nbertamoni/BASIC/README.md

# BASIC stands for Bioimpedance ASIC for Skin Cancer detection
This is a application specific integrated circuit project for skin cancer detection.
UNIC CASS
