nbertamoni/BASIC/documentation/UNIC-CASS_3rd_ed_FUP_2025_12_08.pdf

UNIC-CASS 3rd ed.

# The BASIC Project

# Florianópolis, December 8, 2025

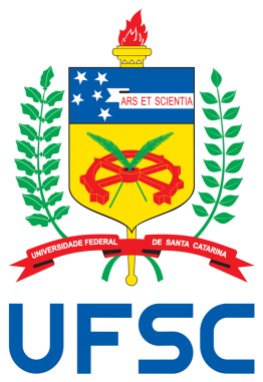
[picture p1: figure]
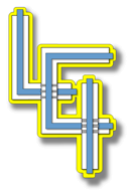
[picture p2: figure]

# A problem

Global cancer growth projections | One more way to help…

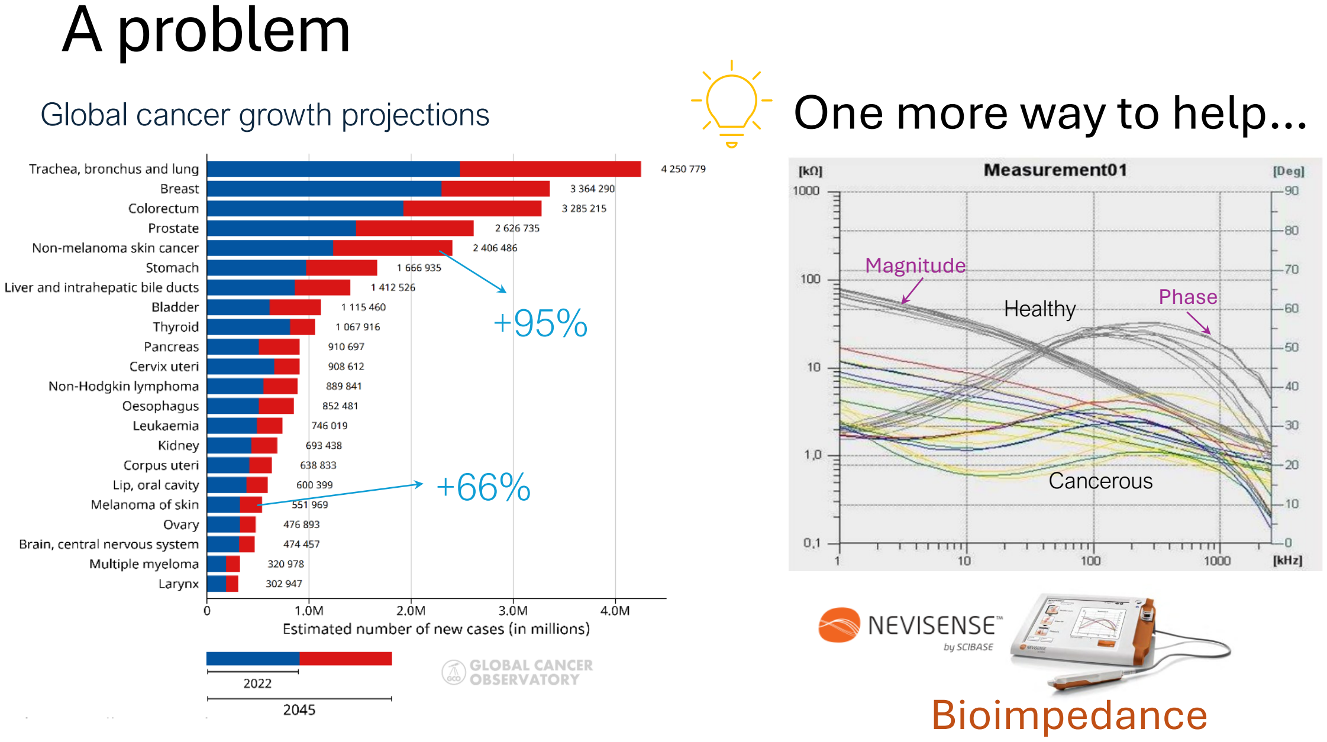
[picture p3: page 2]

+95%

+66%

Healthy

Cancerous

Magnitude
Phase

# Bioimpedance

# The BASIC Project

Bioimpedance | ASIC | UNIC-CASS - 2023 (1st ed.)

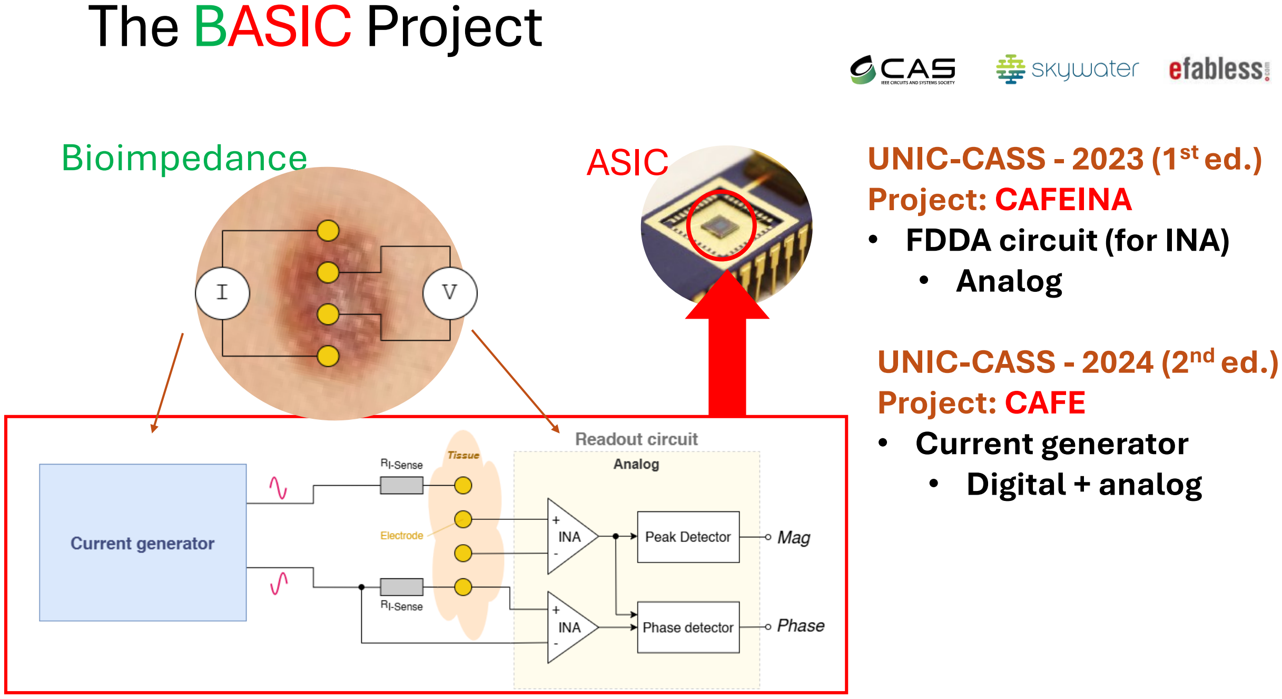
[picture p4: page 3]

# Project: CAFEINA - FDDA circuit (for INA) - Analog

# UNIC-CASS - 2024 (2nd ed.) Project: CAFE - Current generator - Digital + analog

# BASIC – detailed current gen

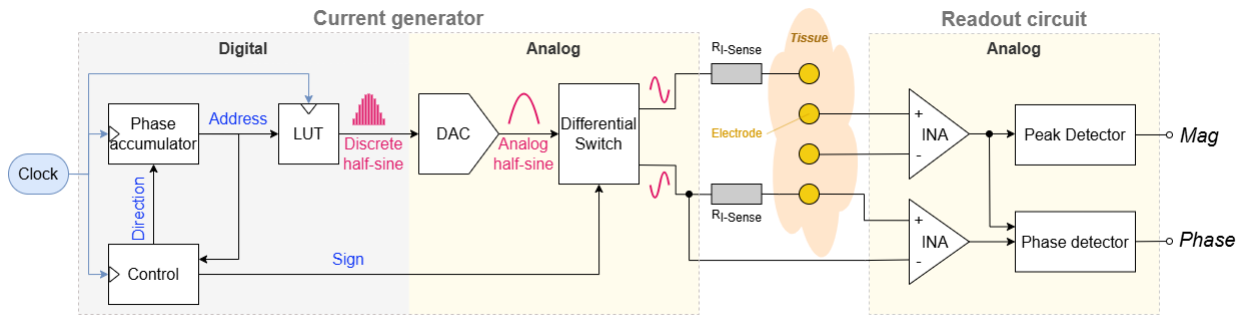
[picture p5: figure]

# BASIC - detailed readout

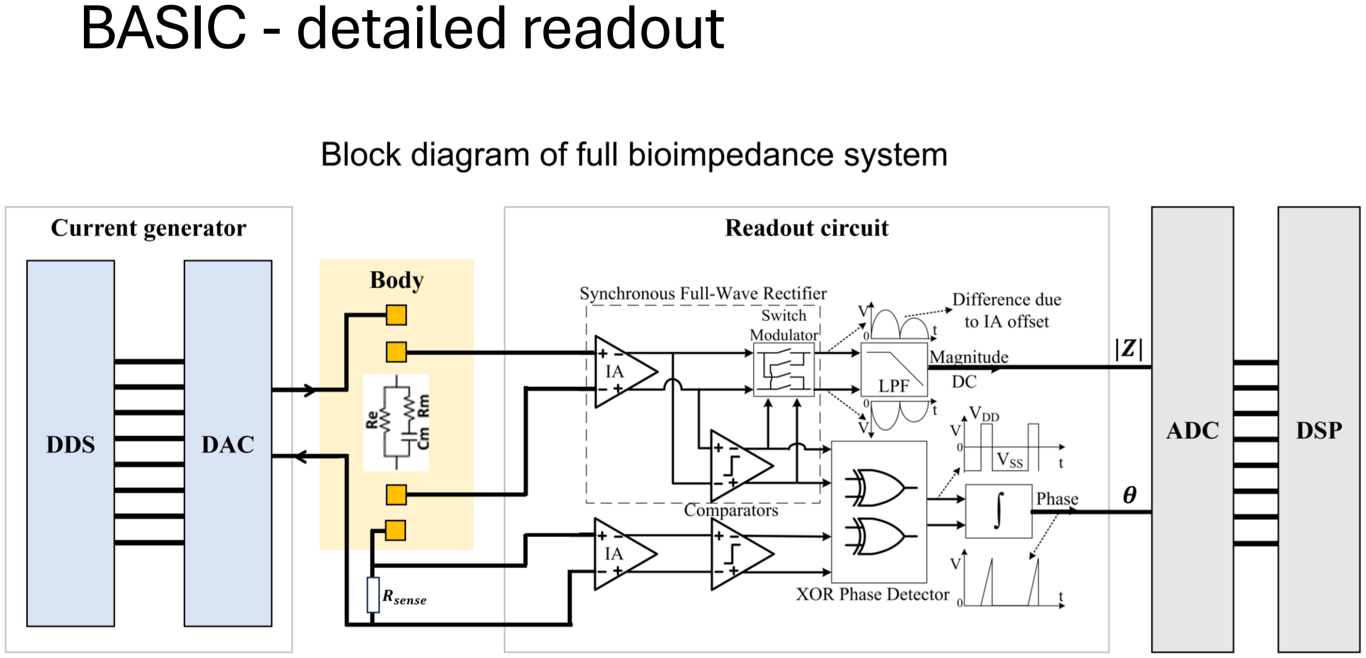
[picture p6: page 5]

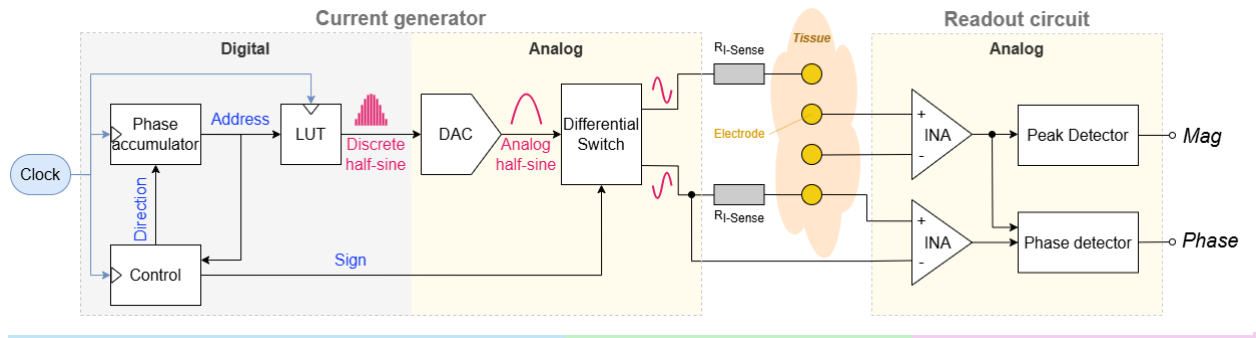
[picture p7: figure]

→ Plan A | → Plan B | → Plan C

# UNIC-CASS 3rd ed. (2025)

## Current generator - Digital: FSM+LUT - Analog: DAC + Diff switch Readout circuit - Analog: INA + Peak detector + Phase detector

## Current generator - Digital: FSM+LUT - Analog: DAC + Diff switch Readout circuit - Analog: INA

## Current generator - Digital: FSM+LUT - Analog: DAC + Diff switch

# Plan A

# | Pin name | Size | Direction | Domain | Description

1 | AVDD | 1 | IO | Power | Supply for analog domain
2 | VSS | 1 | IO | Ground | Ground
3 | DVDD | 1 | IO | Power | Supply for digital domain
4 | CC_P | 1 | IO | Analog | Positive CC
5 | CC_N | 1 | IO | Analog | Negative CC
6 | PU_P | 1 | IO | Analog | Positive PU
7 | PU_N | 1 | IO | Analog | Negative PU
8 | IREF_DAC | 1 | Input | Analog | DAC reference current
9 | IREF_INA | 1 | Input | Analog | INA reference current
10 | IGEN_SEL | 1 | Input | Digital | Current selector
11 | GSEL<1:0> | 2 | Input | Digital | INA gain selector
12 | CLK | 1 | Input | Digital | 1MHz – 510 MHz
13 | RST | 1 | Input | Digital | Rst for digital
14 | VCM | 1 | Input | Analog | External CM voltage
15 | EN_AN | 1 | Input | Digital | Enable for analog blocks
16 | Magnitude | 1 | Output | Analog | Mag output
17 | Phase | 1 | Output | Analog | Phase output

## - 17 pins (min) - W/out debug points - W/out test mode selection

# → Plan A

## Current generator - Digital: FSM+LUT - Analog: DAC + Diff switch Readout circuit - Analog: + INA + Peak detector + Phase detector

# Plan B

# | Pin name | Size | Direction | Domain | Description

1 | AVDD | 1 | IO | Power | Supply for analog domain
2 | VSS | 1 | IO | Ground | Ground
3 | DVDD | 1 | IO | Power | Supply for digital domain
4 | CC_P | 1 | IO | Analog | Positive CC
5 | CC_N | 1 | IO | Analog | Negative CC
6 | PU_P | 1 | IO | Analog | Positive PU
7 | PU_N | 1 | IO | Analog | Negative PU
8 | IREF_DAC | 1 | Input | Analog | DAC reference current
9 | IREF_INA | 1 | Input | Analog | INA reference current
10 | IGEN_SEL | 1 | Input | Digital | Current selector
11 | GSEL<1:0> | 2 | Input | Digital | INA gain selector
12 | CLK | 1 | Input | Digital | 1MHz – 510 MHz
13 | RST | 1 | Input | Digital | Rst for digital
14 | VCM | 1 | Input | Analog | External CM voltage
15 | EN_AN | 1 | Input | Digital | Enable for analog blocks
16 | Magnitude | 1 | Output | Analog | Mag output
17 | Phase | 1 | Output | Analog | Phase output

## - 15 pins (min) - W/out debug points - W/out test mode selection

# → Plan B

## Current generator - Digital: FSM+LUT - Analog: DAC + Diff switch Readout circuit - Analog: INA

# Plan C

# | Pin name | Size | Direction | Domain | Description

1 | AVDD | 1 | IO | Power | Supply for analog domain
2 | VSS | 1 | IO | Ground | Ground
3 | DVDD | 1 | IO | Power | Supply for digital domain
4 | CC_P | 1 | IO | Analog | Positive CC
5 | CC_N | 1 | IO | Analog | Negative CC
6 | PU_P | 1 | IO | Analog | Positive PU
7 | PU_N | 1 | IO | Analog | Negative PU
6 8 | IREF_DAC | 1 | Input | Analog | DAC reference current
9 | IREF_INA | 1 | Input | Analog | INA reference current
7 10 | IGEN_SEL | 1 | Input | Digital | Current selector
11 | GSEL<1:0> | 2 | Input | Digital | INA gain selector
8 12 | CLK | 1 | Input | Digital | 1MHz – 510 MHz
9 13 | RST | 1 | Input | Digital | Rst for digital
14 | VCM | 1 | Input | Analog | External CM voltage
10 15 | EN_AN | 1 | Input | Digital | Enable for analog blocks
16 | Magnitude | 1 | Output | Analog | Mag output
17 | Phase | 1 | Output | Analog | Phase output

## - 10 pins (min) - W/out debug points - W/out test mode selection

# → Plan C

## Current generator - Digital: FSM+LUT - Analog: DAC + Diff switch

# IGEN (Current Generator) - DDS

Block | Pin name | Size | Direction | Domain | Description
DDS | CLK | 1 | Input | Digital | 1MHz – 510 MHz
| RST | 1 | Input | Digital | Rst for digital
| DVDD | 1 | IO | Power | Supply for digital domain
| SIGN | 1 | Output | Digital | Control sign of sine
| SIGNB | 1 | Output | Digital | Complementary control
| SINE_OUT<17:0> | 18 | Output | Digital | Control for 4T3B- DAC

## - Verilog: 6 pins - DDS for layout: 6 pins + DVDD+DVSS = 8 pins - W/out debug points

## - Verilog for DDS done (no debug or sel mode included)

- If include inverter in DSW input SIGNB could be eliminated.
- If non-overlap circuit added, SIGNB could be eliminated.

# IGEN (Current Generator) - DAC

Block | Pin name | Size | Direction | Domain | Description
| AVDD | 1 | IO | Analog | Supply for analog domain
| AVSS | 1 | IO | Analog | Ground for analog domain
| IREF | 1 | IO | Analog | Reference current
| DATA<17:0> | 18 | Input | Digital | 15 thermometric current sources <17:3> 3 binary current sources <2:0>
| SEL_IGEN | 1 | Input | Digital | Current selector
| EN_AN | 1 | Input | Digital | Enable for analog blocks
| ISUM<17:0> | 18 or 1 | Output | Analog | Analog output

DAC

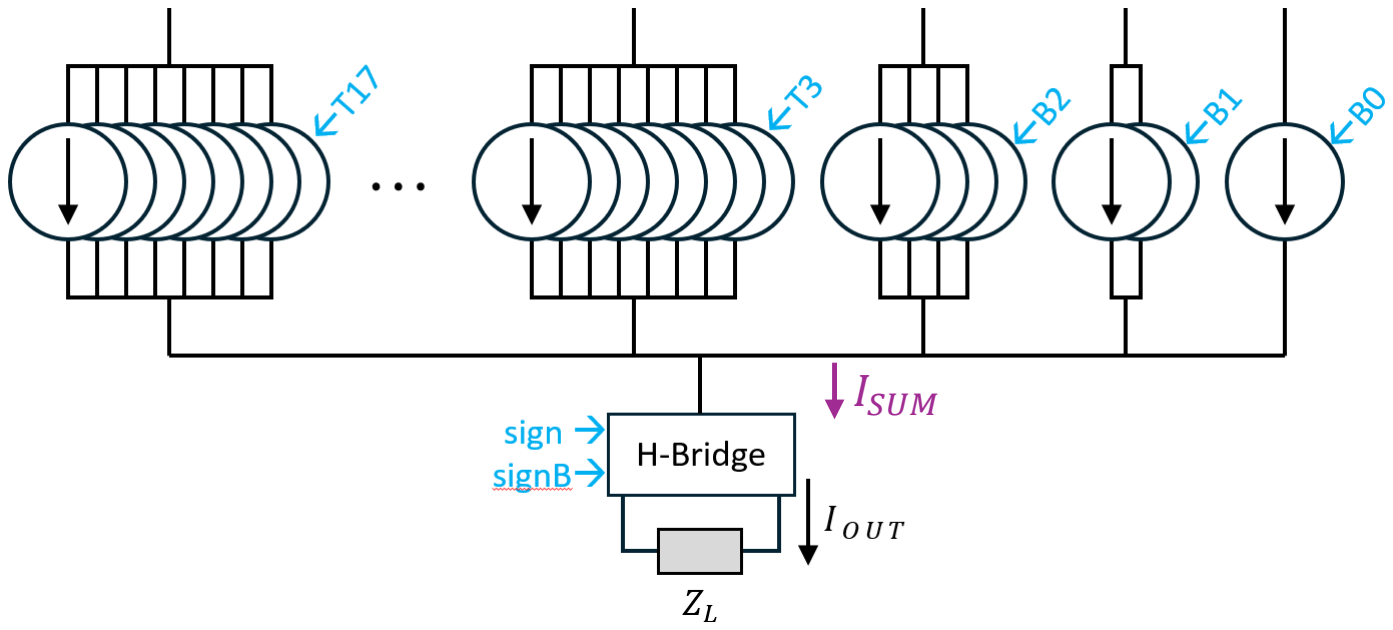
[picture p8: figure]
ISUM

## - 4T3B DAC: 15 thermometric current sources <17:3> 3 binary current sources <2:0>

## - ISUM could be short circuited, since output goes to 1 size

input of DSW.

## - Total: 24 pins (min) or 41 pins (ISUM<17:0>)

# IGEN (Current Generator) - DAC

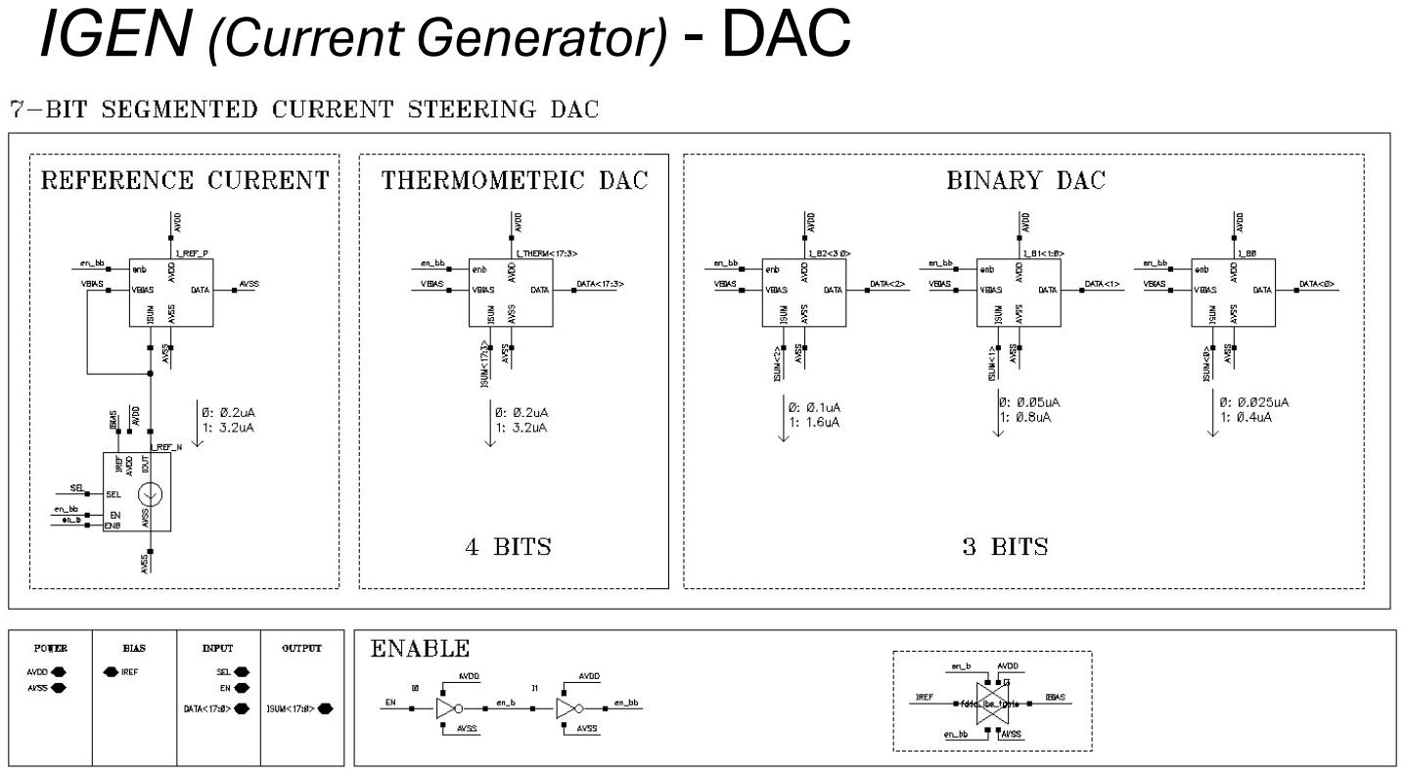
[picture p9: page 12]

# IGEN (Current Generator) - DAC

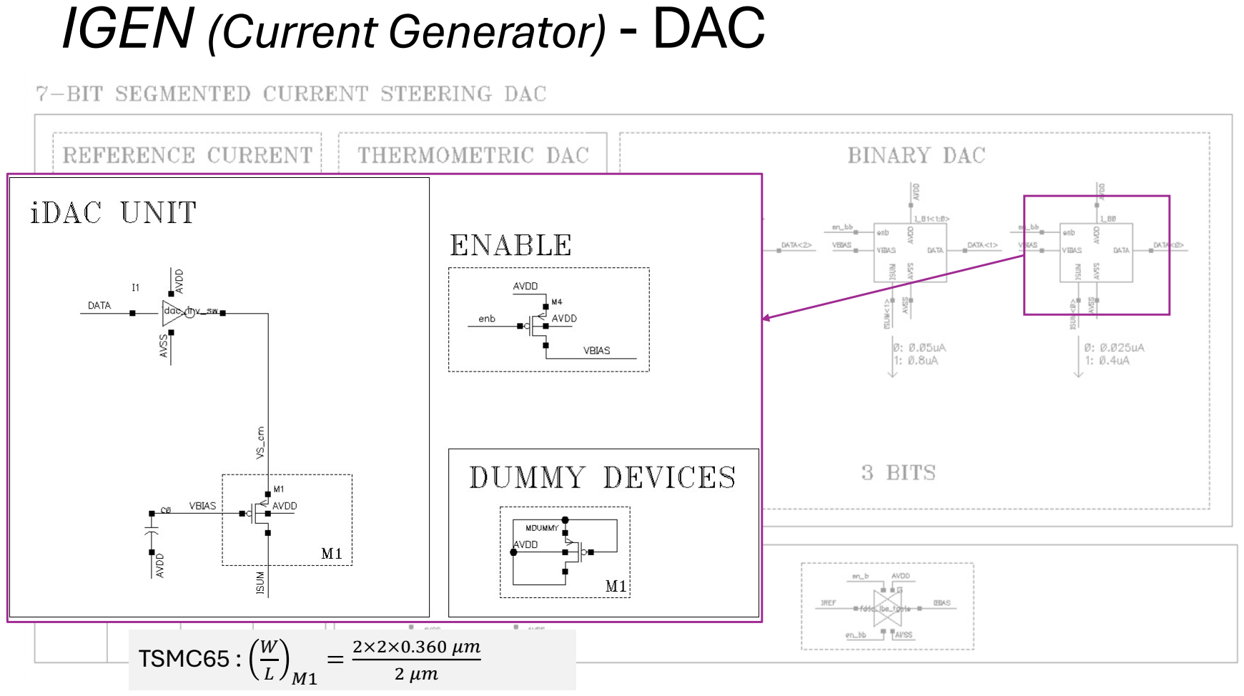
[picture p10: page 13]

## TSMC65 : W

L M1

=

2×2×0.360 μm
2 μm

# IGEN (Current Generator) - DAC

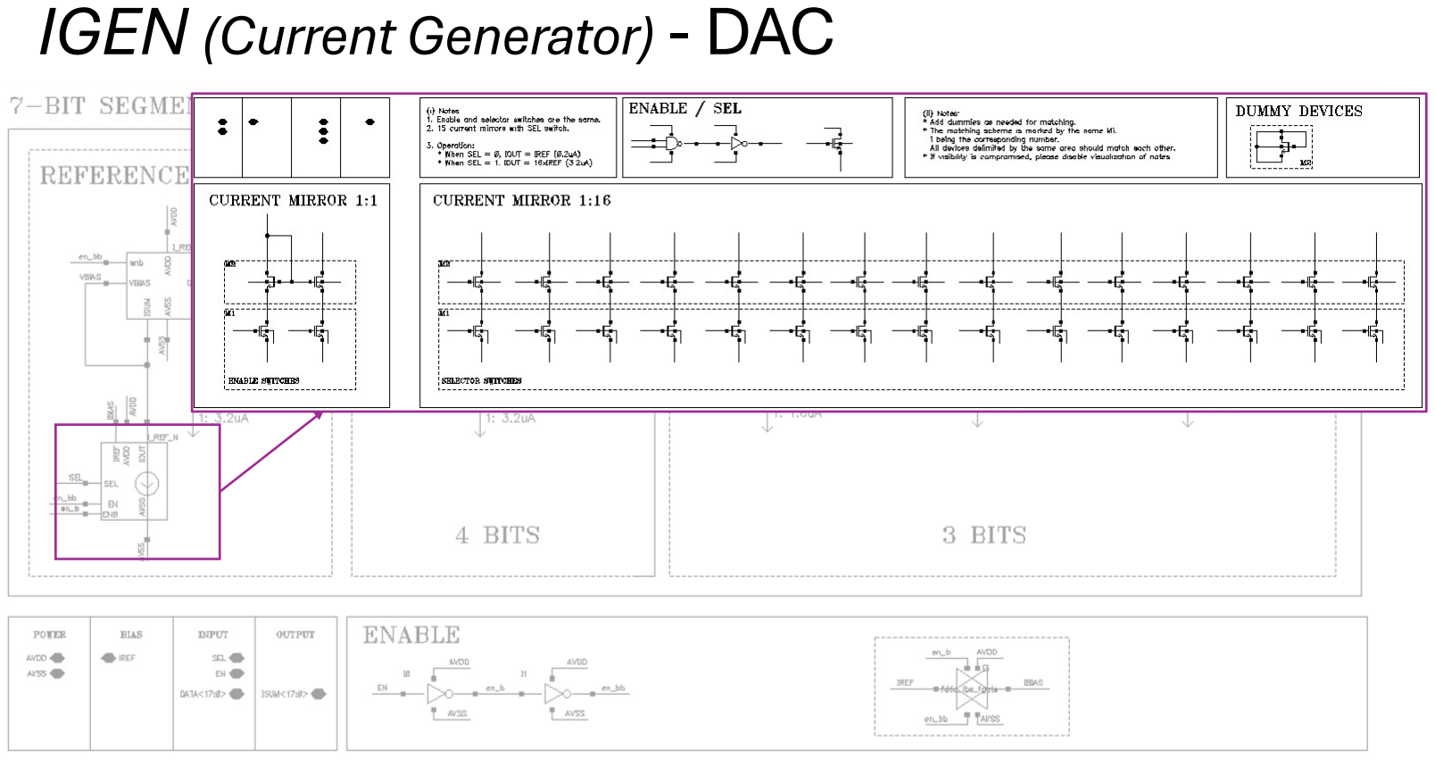
[picture p11: page 14]

# IGEN (Current Generator) - DSW

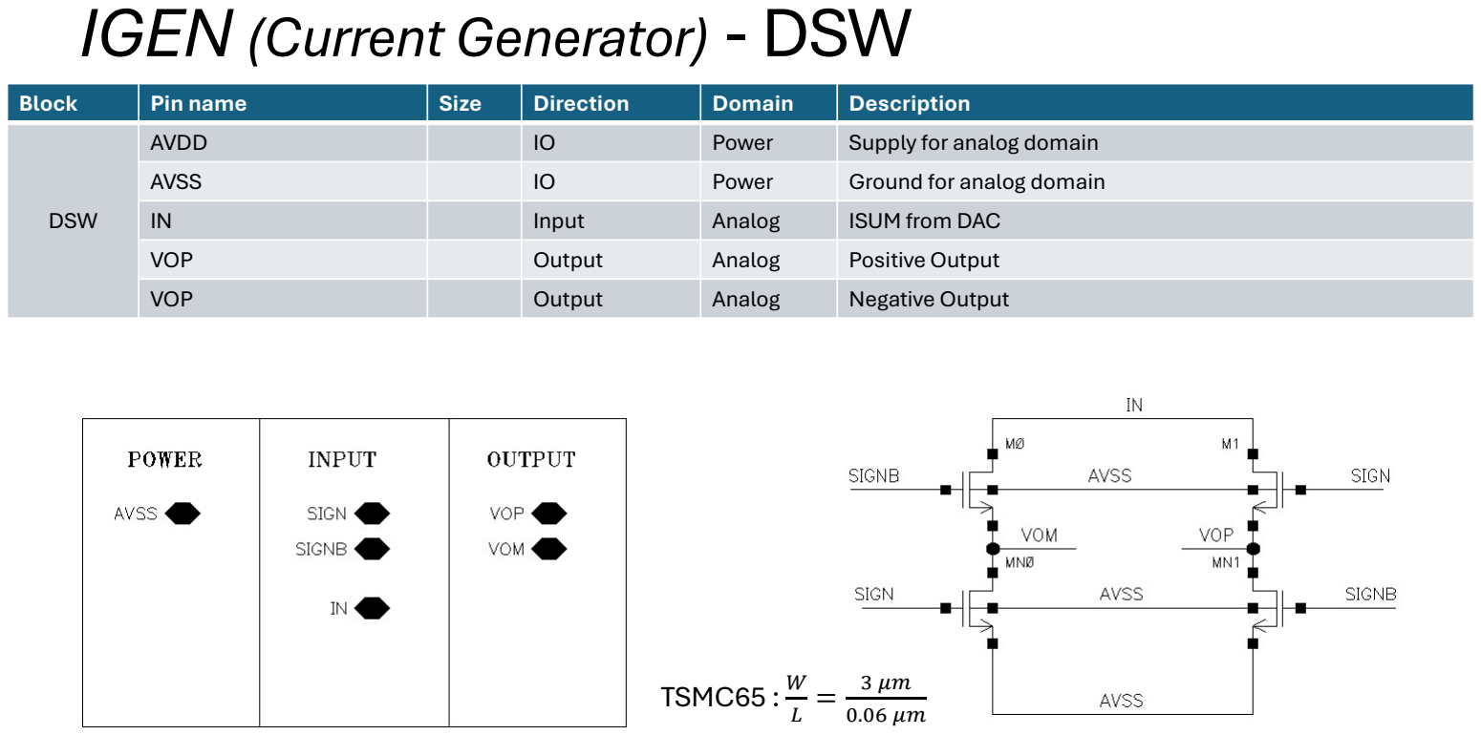
[picture p12: page 15]

Block | Pin name | Size | Direction | Domain | Description
DSW | AVDD | | IO | Power | Supply for analog domain
| AVSS | | IO | Power | Ground for analog domain
| IN | | Input | Analog | ISUM from DAC
| VOP | | Output | Analog | Positive Output
| VOP | | Output | Analog | Negative Output

## TSMC65 : W

L

=

3 μm
0.06 μm

# VREAD (Readout circuit) - INA

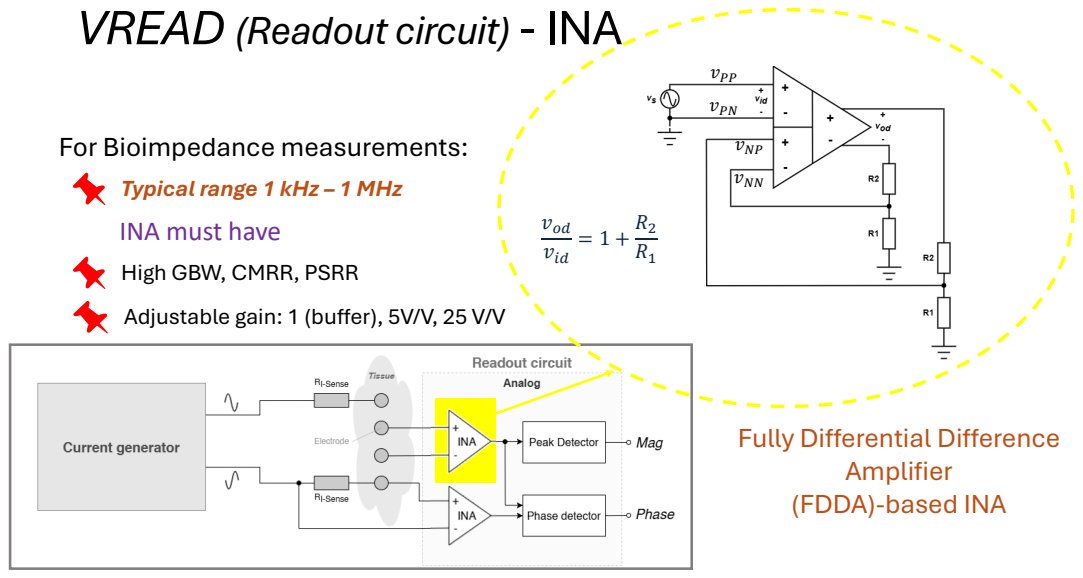
[picture p13: page 16]
vPP; vPN; vNP; vNN; vod; vid

For Bioimpedance measurements:
Typical range 1 kHz – 1 MHz
INA must have
High GBW, CMRR, PSRR
Adjustable gain: 1 (buffer), 5V/V, 25 V/V

Fully Differential Difference

Amplifier
(FDDA)-based INA

# VREAD (Readout circuit) – INA (FDDA)

## Desired:

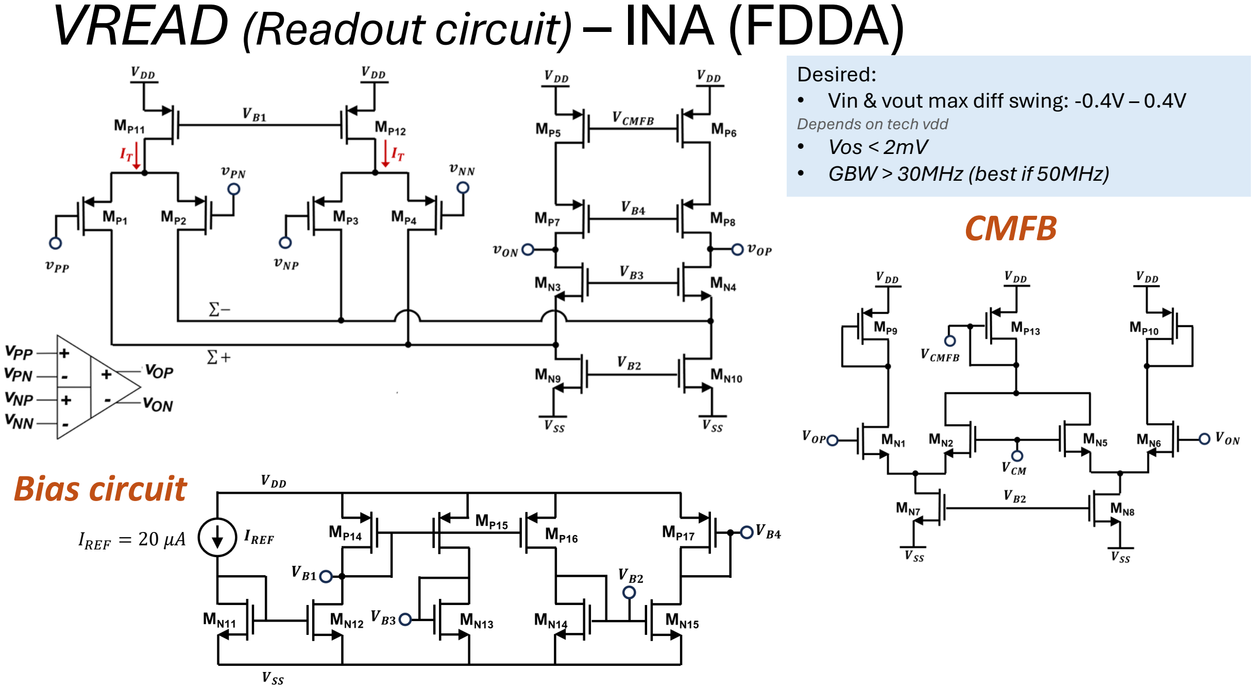
[picture p14: page 17]

# Bias circuit

IREF = 20 μA

# CMFB

## - Vin & vout max diff swing: -0.4V – 0.4V

Depends on tech vdd

## - Vos < 2mV - GBW > 30MHz (best if 50MHz)

# VREAD (Readout circuit) – INA (FDDA)

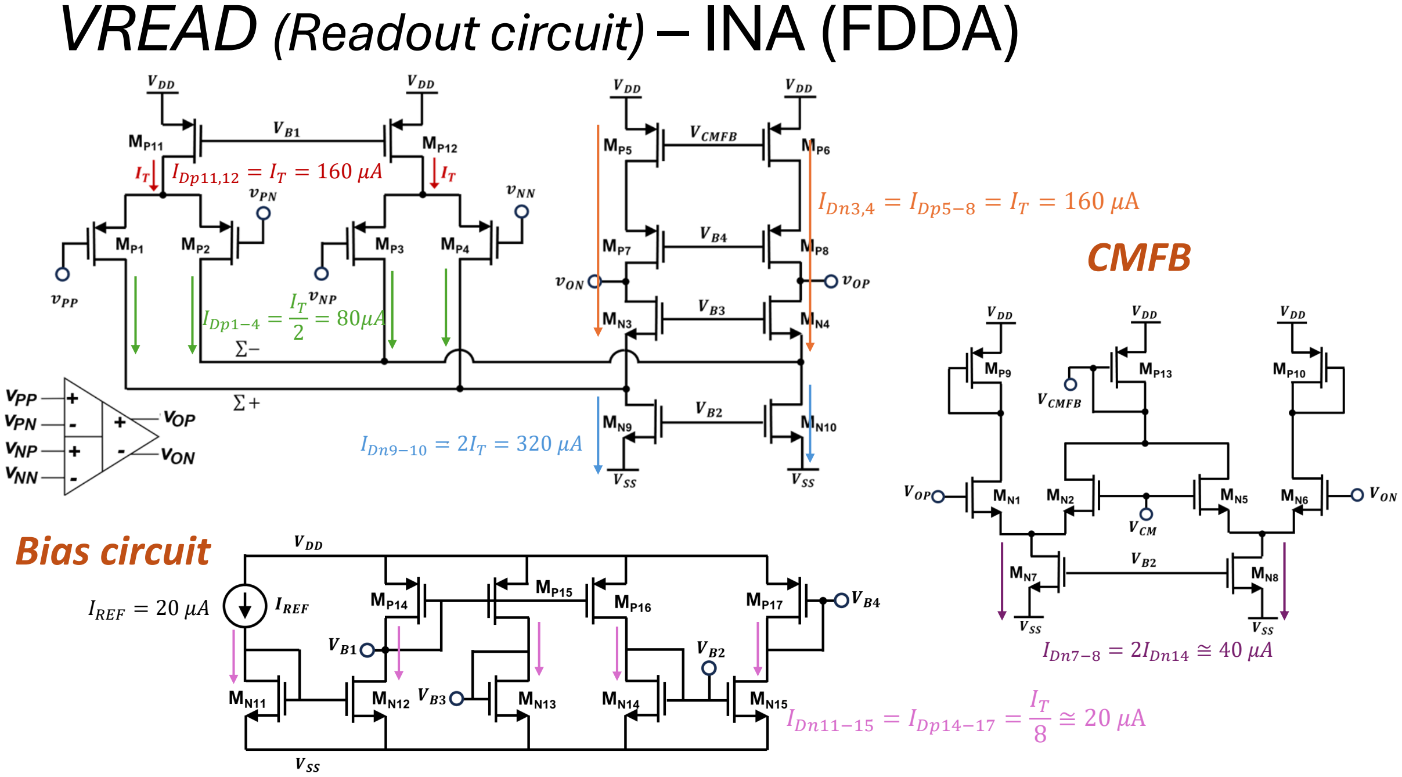
[picture p15: page 18]

# CMFB

# Bias circuit

IDp1−4 =

IT
2

= 80μA

IDn9−10 = 2IT = 320 μA

IDn3,4 = IDp5−8 = IT = 160 μA

IDp11,12 = IT = 160 μA

IDn11−15 = IDp14−17 =

IT
8

≅ 20 μA

IDn7−8 = 2IDn14 ≅ 40 μA

IREF = 20 μA

# VREAD (Readout circuit) – INA (FDDA)

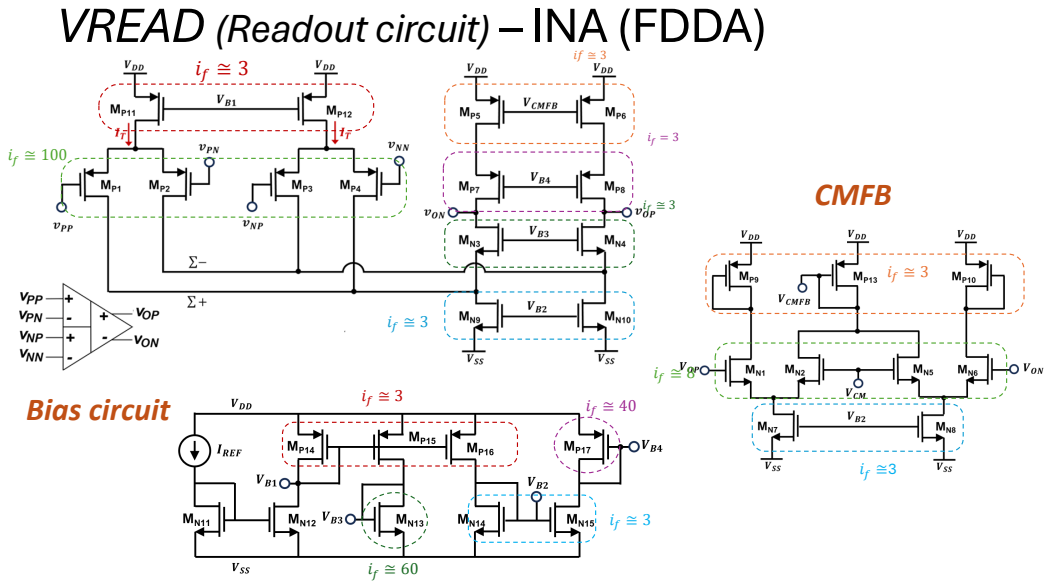
[picture p16: page 19]
CMFB; Bias circuit

# VREAD (Readout circuit) – INA (FDDA)

| Device | Type | ID [uA]
| | | (ideal) | if (ideal) | W [um] (tot)
| | | | | m x nf x W | L [um] (tot)
| | | | | | Series x L | S
| | | | | | | (calculated)
Input pair | MP1-4 | P-lvt | 80 | 100 | 24x2x0.5=24 | 2 | 12
Itail P | MP11-12 | P-svt | 160 | 3 | 128x4x3.5=1792 | 2 | 896
| MP5-6 | P-svt | 160 | 3 | 128x4x3.5=1792 | 2 | 896
| MP7-8 | P-svt | 160 | 3 | 64x4x3.5=896 | 1 | 896
Current
source N | MN9-10 | N-lvt | 320 | 3 | 256x4x2 | 2 | 1024
Cascode N | MN3-4 | N-lvt | 160 | 3 | 80x4x1.6=512 | 2 | 512
Bias P | MP14-16 | P-svt | 20 | 3 | 16x4x3.5=224 | 2 | 112
Bias P | MP17 | P-svt | 20 | 40 | 9x4x3.5=126 | 8x2=16 | 7.88
Bias N | MN14-15 | N-lvt | 20 | 3 | 16x4x2=128 | 2 | 64
Bias N | MN16 | N-lvt | 20 | 60 | 8x4x1.6=51.2 | 8x2=16 | 3.2
CMFB pair | MN1-2,5-6 | N-lvt | 20 | 8 | 24x2x1.5=72 | 0.5 | 144
CMFB tail | MN7-8 | P-svt | 40 | 3 | 32x4x2=256 | 2 | 128
CMFB P | MP9-10 | P-svt | 20 | 3 | 16x4x3.5=224 | 2 | 112
CMFB P | MP13 | P-svt | 40 | 3 | 32x4x3.5=224 | 2 | 224

# UNIC-CASS: Schedule

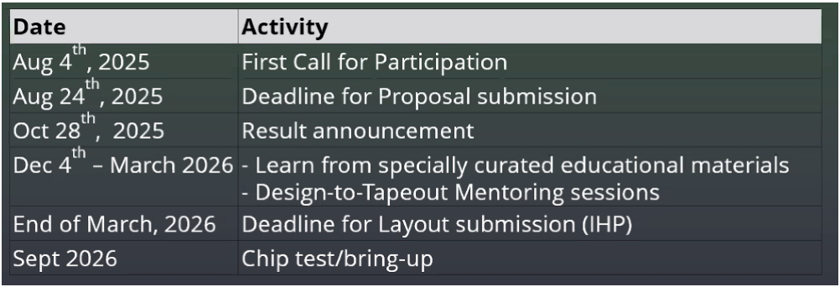
[picture p17: figure]

# UNIC-CASS: Schedule

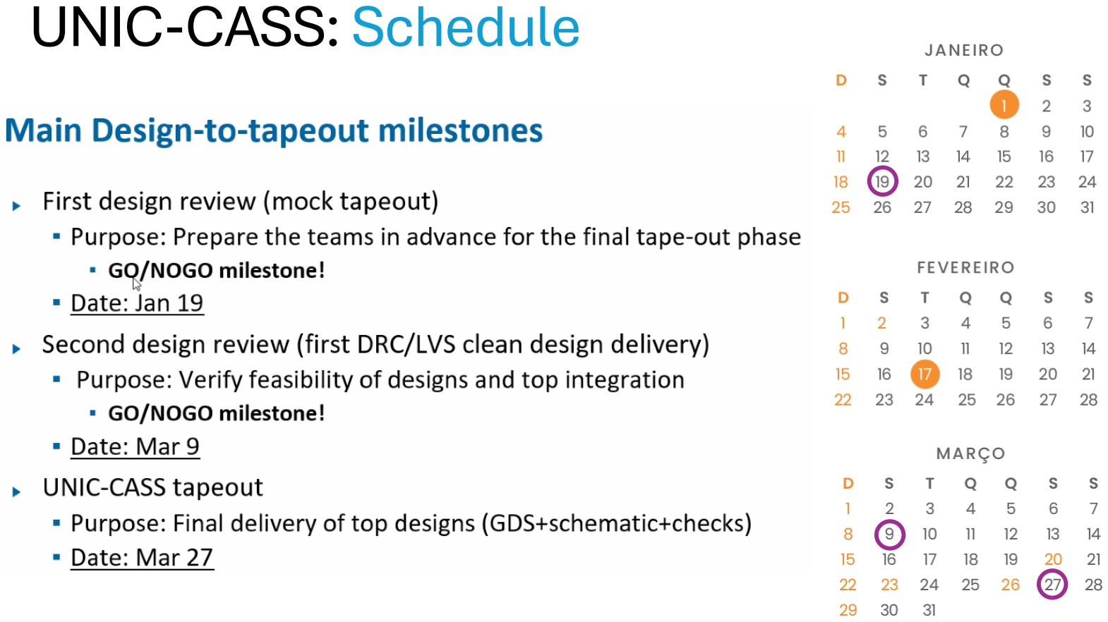
[picture p18: page 22]

# UNIC-CASS: Tech

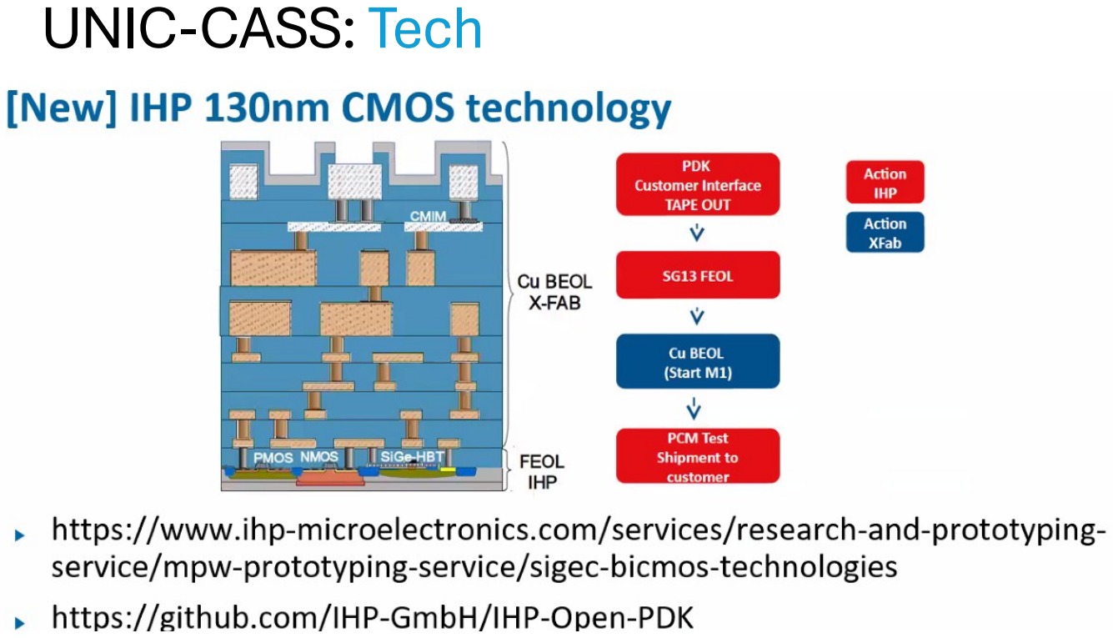
[picture p19: page 23]

# UNIC-CASS: Tech

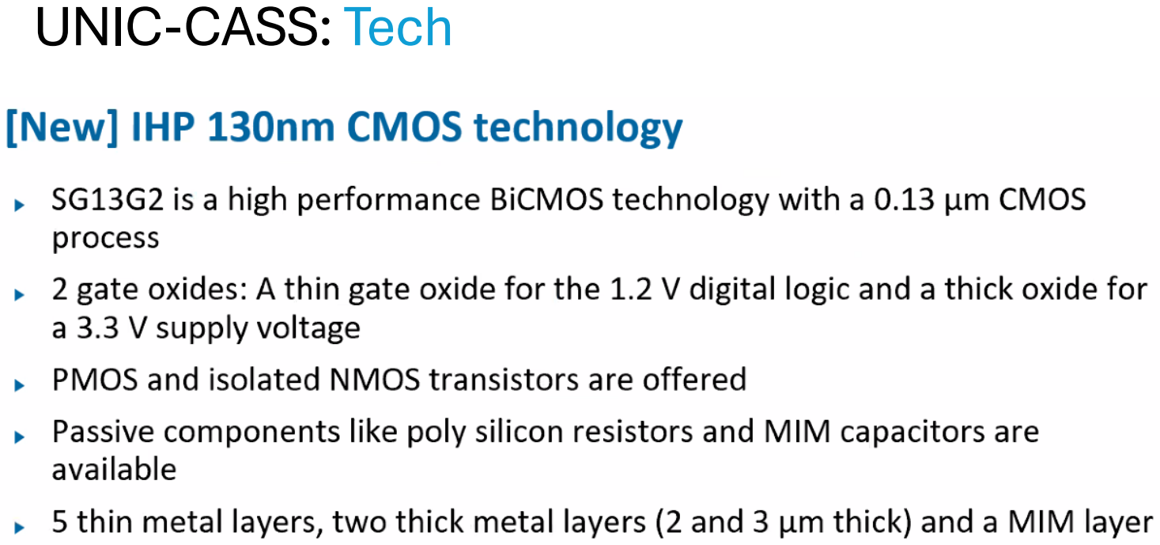
[picture p20: page 24]

# UNIC-CASS: Mentoring

# - IHP process

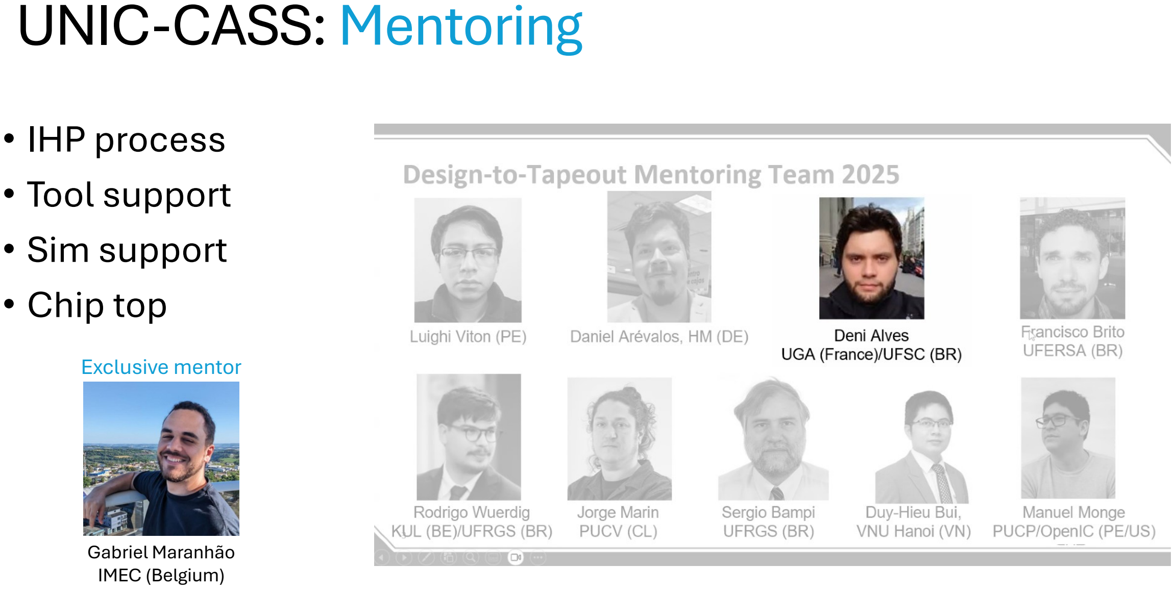
[picture p21: page 25]

# - Tool support - Sim support - Chip top

Gabriel Maranhão
IMEC (Belgium)

## Exclusive mentor

# UNIC-CASS: Mentoring

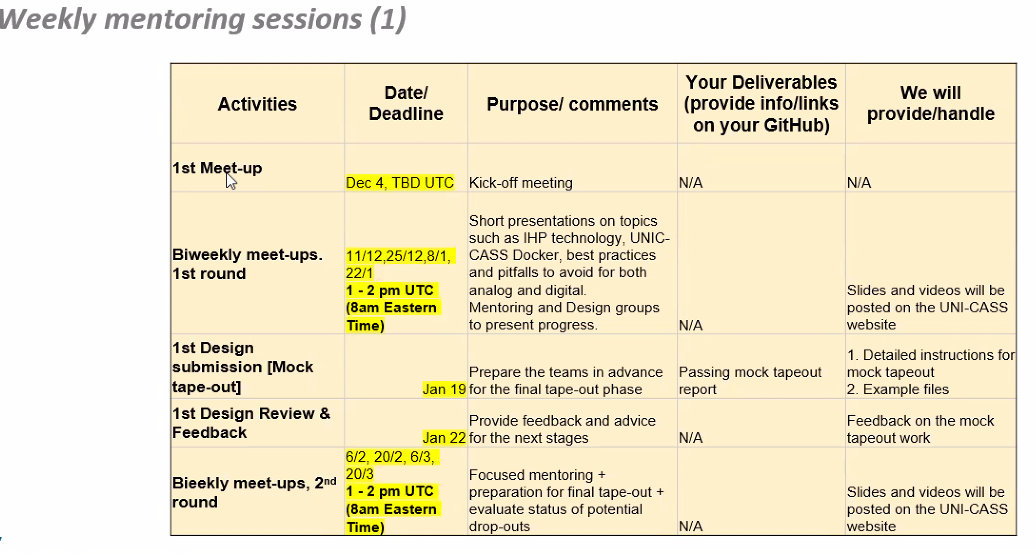
[picture p22: page 26]

# UNIC-CASS: Mentoring

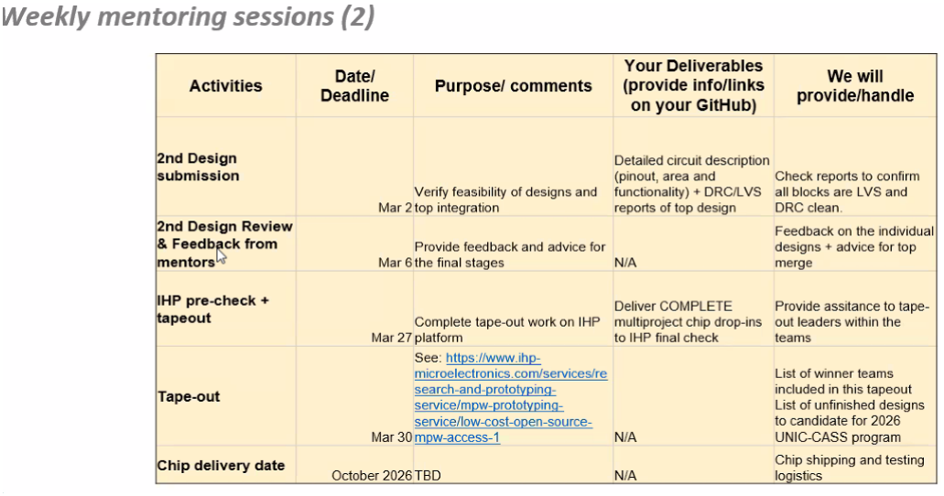
[picture p23: figure]

# UNIC-CASS: Mentoring

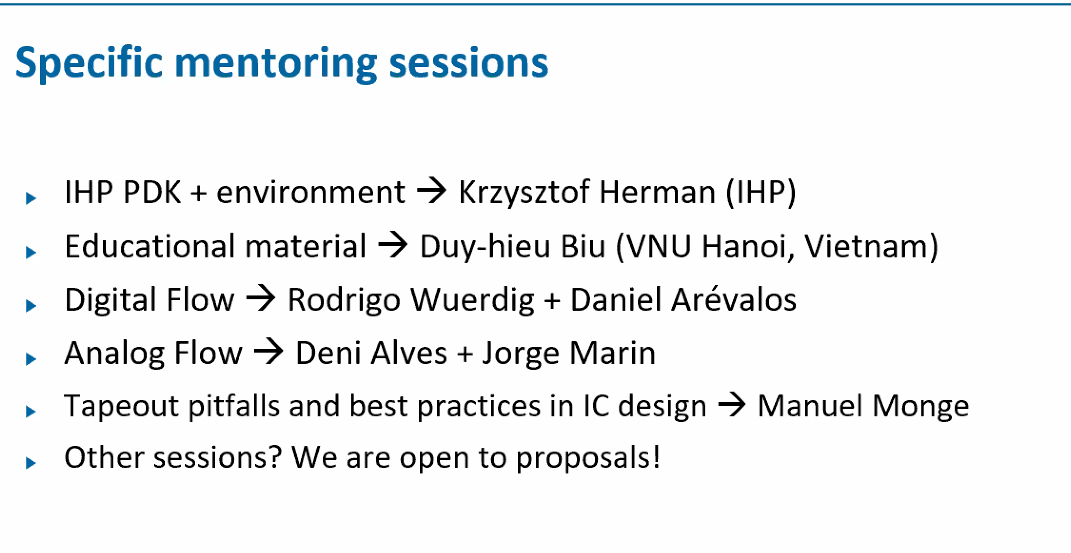
[picture p24: page 28]
