nbertamoni/BASIC/current_generator/digital/DigitalSine/runs/RUN_2026-02-26_20-53-18/56-openroad-irdropreport/net-VGND.csv

Instance | Terminal | Layer | X location | Y location | Voltage
FILLER_14_117 | VSS | Metal1 | 62.4000 | 68.0400 | 0.000000
FILLER_14_92 | VSS | Metal1 | 50.4000 | 68.0400 | 0.000000
FILLER_14_70 | VSS | Metal1 | 39.6000 | 68.0400 | 0.000000
FILLER_14_68 | VSS | Metal1 | 38.8800 | 68.0400 | 0.000000
FILLER_14_20 | VSS | Metal1 | 15.6000 | 68.0400 | 0.000000
FILLER_14_14 | VSS | Metal1 | 12.7200 | 68.0400 | 0.000000
FILLER_13_118 | VSS | Metal1 | 62.6400 | 68.0400 | 0.000000
FILLER_13_116 | VSS | Metal1 | 61.9200 | 68.0400 | 0.000000
FILLER_13_53 | VSS | Metal1 | 31.4400 | 68.0400 | 0.000000
FILLER_13_51 | VSS | Metal1 | 30.7200 | 68.0400 | 0.000000
FILLER_13_29 | VSS | Metal1 | 19.9200 | 68.0400 | 0.000000
FILLER_13_22 | VSS | Metal1 | 16.8000 | 68.0400 | 0.000000
FILLER_13_16 | VSS | Metal1 | 13.6800 | 68.0400 | 0.000000
FILLER_13_5 | VSS | Metal1 | 8.4000 | 68.0400 | 0.000000
FILLER_12_118 | VSS | Metal1 | 62.6400 | 60.4800 | 0.000000
FILLER_12_116 | VSS | Metal1 | 61.9200 | 60.4800 | 0.000000
FILLER_12_87 | VSS | Metal1 | 47.7600 | 60.4800 | 0.000000
FILLER_12_61 | VSS | Metal1 | 35.2800 | 60.4800 | 0.000000
FILLER_12_52 | VSS | Metal1 | 30.9600 | 60.4800 | 0.000000
FILLER_12_20 | VSS | Metal1 | 15.8400 | 60.4800 | 0.000000
FILLER_11_118 | VSS | Metal1 | 62.6400 | 60.4800 | 0.000000
FILLER_11_93 | VSS | Metal1 | 50.6400 | 60.4800 | 0.000000
FILLER_11_91 | VSS | Metal1 | 49.9200 | 60.4800 | 0.000000
FILLER_11_82 | VSS | Metal1 | 45.3600 | 60.4800 | 0.000000
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
_134_ | VSS | Metal1 | 14.7700 | 29.9920 | 0.000429
_133_ | VSS | Metal1 | 14.8560 | 30.5700 | 0.000429
_132_ | VSS | Metal1 | 33.1430 | 15.4500 | 0.000002
_131_ | VSS | Metal1 | 41.2560 | 60.8100 | 0.000000
_130_ | VSS | Metal1 | 41.3030 | 53.2500 | 0.000124
_129_ | VSS | Metal1 | 15.3830 | 15.4500 | 0.000002
_128_ | VSS | Metal1 | 46.9300 | 68.2870 | 0.000000
