nbertamoni/BASIC/current_generator/digital/DigitalSine/runs/RUN_2026-02-26_20-53-18/56-openroad-irdropreport/net-VPWR.csv

Instance | Terminal | Layer | X location | Y location | Voltage
FILLER_14_117 | VDD | Metal1 | 62.4000 | 71.8200 | 1.200000
FILLER_14_92 | VDD | Metal1 | 50.4000 | 71.8200 | 1.200000
FILLER_14_70 | VDD | Metal1 | 39.6000 | 71.8200 | 1.200000
FILLER_14_68 | VDD | Metal1 | 38.8800 | 71.8200 | 1.200000
FILLER_14_20 | VDD | Metal1 | 15.6000 | 71.8200 | 1.200000
FILLER_14_14 | VDD | Metal1 | 12.7200 | 71.8200 | 1.200000
FILLER_13_118 | VDD | Metal1 | 62.6400 | 64.2600 | 1.200000
FILLER_13_116 | VDD | Metal1 | 61.9200 | 64.2600 | 1.200000
FILLER_13_53 | VDD | Metal1 | 31.4400 | 64.2600 | 1.200000
FILLER_13_51 | VDD | Metal1 | 30.7200 | 64.2600 | 1.200000
FILLER_13_29 | VDD | Metal1 | 19.9200 | 64.2600 | 1.200000
FILLER_13_22 | VDD | Metal1 | 16.8000 | 64.2600 | 1.200000
FILLER_13_16 | VDD | Metal1 | 13.6800 | 64.2600 | 1.200000
FILLER_13_5 | VDD | Metal1 | 8.4000 | 64.2600 | 1.200000
FILLER_12_118 | VDD | Metal1 | 62.6400 | 64.2600 | 1.200000
FILLER_12_116 | VDD | Metal1 | 61.9200 | 64.2600 | 1.200000
FILLER_12_87 | VDD | Metal1 | 47.7600 | 64.2600 | 1.200000
FILLER_12_61 | VDD | Metal1 | 35.2800 | 64.2600 | 1.200000
FILLER_12_52 | VDD | Metal1 | 30.9600 | 64.2600 | 1.200000
FILLER_12_20 | VDD | Metal1 | 15.8400 | 64.2600 | 1.200000
FILLER_11_118 | VDD | Metal1 | 62.6400 | 56.7000 | 1.200000
FILLER_11_93 | VDD | Metal1 | 50.6400 | 56.7000 | 1.200000
FILLER_11_91 | VDD | Metal1 | 49.9200 | 56.7000 | 1.200000
FILLER_11_82 | VDD | Metal1 | 45.3600 | 56.7000 | 1.200000
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
_134_ | VDD | Metal1 | 14.7700 | 26.7910 | 1.199584
_133_ | VDD | Metal1 | 14.8580 | 33.5730 | 1.199455
_132_ | VDD | Metal1 | 33.1410 | 18.4530 | 1.199778
_131_ | VDD | Metal1 | 41.2580 | 63.8130 | 1.200000
_130_ | VDD | Metal1 | 41.3010 | 56.2530 | 1.200000
_129_ | VDD | Metal1 | 15.3810 | 18.4530 | 1.199781
_128_ | VDD | Metal1 | 46.9300 | 71.4880 | 1.200000
