nbertamoni/BASIC/current_generator/analog/DAC/schematics/simulations/dac_bits.spice

** sch_path: /home/designer/shared/BASIC/current_generator/analog/DAC/schematics/dac_bits.sch
.subckt dac_bits AVDD AVSS en_bb DATA[17] DATA[16] DATA[15] DATA[14] DATA[13] DATA[12] DATA[11] DATA[10] DATA[9] DATA[8] DATA[7]
+ DATA[6] DATA[5] DATA[4] DATA[3] DATA[2] DATA[1] DATA[0] VBIAS ISUM
*.PININFO AVDD:B AVSS:B en_bb:B DATA[17:0]:B VBIAS:B ISUM:B
xb0 AVDD AVSS VBIAS en_bb DATA[0] ISUM dac_gold
xb1[1] AVDD AVSS VBIAS en_bb DATA[1] ISUM dac_gold
xb1[0] AVDD AVSS VBIAS en_bb DATA[1] ISUM dac_gold
xb2[3] AVDD AVSS VBIAS en_bb DATA[2] ISUM dac_gold
xb2[2] AVDD AVSS VBIAS en_bb DATA[2] ISUM dac_gold
xb2[1] AVDD AVSS VBIAS en_bb DATA[2] ISUM dac_gold
xb2[0] AVDD AVSS VBIAS en_bb DATA[2] ISUM dac_gold
xb3[7] AVDD AVSS VBIAS en_bb DATA[3] ISUM dac_gold
xb3[6] AVDD AVSS VBIAS en_bb DATA[3] ISUM dac_gold
xb3[5] AVDD AVSS VBIAS en_bb DATA[3] ISUM dac_gold
xb3[4] AVDD AVSS VBIAS en_bb DATA[3] ISUM dac_gold
xb3[3] AVDD AVSS VBIAS en_bb DATA[3] ISUM dac_gold
xb3[2] AVDD AVSS VBIAS en_bb DATA[3] ISUM dac_gold
xb3[1] AVDD AVSS VBIAS en_bb DATA[3] ISUM dac_gold
xb3[0] AVDD AVSS VBIAS en_bb DATA[3] ISUM dac_gold
xb4[7] AVDD AVSS VBIAS en_bb DATA[4] ISUM dac_gold
xb4[6] AVDD AVSS VBIAS en_bb DATA[4] ISUM dac_gold
xb4[5] AVDD AVSS VBIAS en_bb DATA[4] ISUM dac_gold
xb4[4] AVDD AVSS VBIAS en_bb DATA[4] ISUM dac_gold
xb4[3] AVDD AVSS VBIAS en_bb DATA[4] ISUM dac_gold
xb4[2] AVDD AVSS VBIAS en_bb DATA[4] ISUM dac_gold
xb4[1] AVDD AVSS VBIAS en_bb DATA[4] ISUM dac_gold
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
x147 AVDD AVSS dac_DUMMIE
x148 AVDD AVSS dac_DUMMIE
x149 AVDD AVSS dac_DUMMIE
x150 AVDD AVSS dac_DUMMIE
x151 AVDD AVSS dac_DUMMIE
x152 AVDD AVSS dac_DUMMIE
x153 AVDD AVSS dac_DUMMIE
x154 AVDD AVSS dac_DUMMIE
x155 AVDD AVSS dac_DUMMIE
x156 AVDD AVSS dac_DUMMIE
x157 AVDD AVSS dac_DUMMIE
.ends

* expanding   symbol:  dac_gold.sym # of pins=6
** sym_path: /home/designer/shared/BASIC/current_generator/analog/DAC/schematics/dac_gold.sym
** sch_path: /home/designer/shared/BASIC/current_generator/analog/DAC/schematics/dac_gold.sch
.subckt dac_gold AVDD AVSS VBIAS enb DATA ISUM
*.PININFO AVDD:B AVSS:B VBIAS:B enb:B DATA:B ISUM:B
MM1 ISUM VBIAS VS_cm AVDD sg13_lv_pmos w=0.72u l=3u ng=1 m=4
MM2 VBIAS enb AVDD AVDD sg13_lv_pmos w=0.72u l=3u ng=1 m=4
MM3 AVDD AVDD AVDD AVDD sg13_lv_pmos w=0.72u l=1.5u ng=1 m=8
x20 DATA VS_cm AVDD AVSS inverter
.ends


* expanding   symbol:  dac_DUMMIE.sym # of pins=2
** sym_path: /home/designer/shared/BASIC/current_generator/analog/DAC/schematics/dac_DUMMIE.sym
** sch_path: /home/designer/shared/BASIC/current_generator/analog/DAC/schematics/dac_DUMMIE.sch
.subckt dac_DUMMIE AVDD AVSS
*.PININFO AVDD:B AVSS:B
MMN0 AVSS AVDD AVSS AVSS sg13_lv_nmos w=740.00n l=130.00n ng=1
MMP0 AVSS AVDD AVDD AVDD sg13_lv_pmos w=1.12u l=130.00n ng=1
MMP11 AVDD AVDD AVDD AVDD sg13_lv_pmos w=0.72u l=1.5u ng=1
MP12 AVDD AVDD AVDD AVDD sg13_lv_pmos w=0.72u l=1.5u ng=1
MP13 AVDD AVDD AVDD AVDD sg13_lv_pmos w=0.72u l=1.5u ng=1
MP14 AVDD AVDD AVDD AVDD sg13_lv_pmos w=0.72u l=1.5u ng=1
MP15 AVDD AVDD AVDD AVDD sg13_lv_pmos w=0.72u l=1.5u ng=1
MP16 AVDD AVDD AVDD AVDD sg13_lv_pmos w=0.72u l=1.5u ng=1
MP17 AVDD AVDD AVDD AVDD sg13_lv_pmos w=0.72u l=1.5u ng=1
MP18 AVDD AVDD AVDD AVDD sg13_lv_pmos w=0.72u l=1.5u ng=1
MMP51 AVDD AVDD AVDD AVDD sg13_lv_pmos w=0.72u l=3u ng=1
MP52 AVDD AVDD AVDD AVDD sg13_lv_pmos w=0.72u l=3u ng=1
MP53 AVDD AVDD AVDD AVDD sg13_lv_pmos w=0.72u l=3u ng=1
MP54 AVDD AVDD AVDD AVDD sg13_lv_pmos w=0.72u l=3u ng=1
MMP21 AVDD AVDD AVDD AVDD sg13_lv_pmos w=0.72u l=3u ng=1
MP22 AVDD AVDD AVDD AVDD sg13_lv_pmos w=0.72u l=3u ng=1
MP23 AVDD AVDD AVDD AVDD sg13_lv_pmos w=0.72u l=3u ng=1
MP24 AVDD AVDD AVDD AVDD sg13_lv_pmos w=0.72u l=3u ng=1
.ends


* expanding   symbol:  inverter.sym # of pins=4
** sym_path: /home/designer/shared/BASIC/current_generator/analog/DAC/schematics/inverter.sym
** sch_path: /home/designer/shared/BASIC/current_generator/analog/DAC/schematics/inverter.sch
.subckt inverter A Y VDD VSS
*.PININFO Y:O A:I VDD:B VSS:B
MMN0 Y A VSS VSS sg13_lv_nmos w=740.00n l=130.00n ng=1
MMP0 Y A VDD VDD sg13_lv_pmos w=1.12u l=130.00n ng=1
.ends
