nbertamoni/BASIC/current_generator/digital/DigitalSine/runs/RUN_2026-02-26_20-53-18/13-openroad-floorplan/DigitalSine.nl.v

module DigitalSine (clk,
    rst,
    sign,
    signB,
    sine_out);
 input clk;
 input rst;
 output sign;
 output signB;
 output [17:0] sine_out;

 wire \CTRL.P0 ;
 wire \CTRL.P1 ;
 wire \CTRL.S0 ;
 wire \DPATH.SUM.Cout0 ;
 wire \DPATH.SUM.fa_1.A ;
 wire \DPATH.SUM.fa_1.S ;
 wire \DPATH.SUM.fa_2.A ;
 wire \DPATH.SUM.fa_2.S ;
 wire \DPATH.SUM.fa_3.A ;
 wire \DPATH.SUM.fa_3.S ;
 wire \DPATH.SUM.fa_4.A ;
 wire \DPATH.SUM.fa_4.S ;
 wire \DPATH.SUM.fa_5.A ;
 wire \DPATH.SUM.fa_5.S ;
 wire \DPATH.SUM.fa_6.A ;
 wire \DPATH.SUM.fa_6.S ;
 wire \DPATH.SUM.ha_0.S ;
 wire _000_;
 wire _001_;
 wire _002_;
 wire _003_;
 wire _004_;
 wire _005_;
 wire _006_;
 wire _007_;
 wire _008_;
 wire _009_;
 wire _010_;
 wire _011_;
 wire _012_;
 wire _013_;
 wire _014_;
 wire _015_;
 wire _016_;
 wire _017_;
 wire _018_;
 wire _019_;
 wire _020_;
 wire _021_;
 wire _022_;
 wire _023_;
 wire _024_;
 wire _025_;
 wire _026_;
 wire _027_;
 wire _028_;
 wire _029_;
 wire _030_;
 wire _031_;
 wire _032_;
 wire _033_;
 wire _034_;
 wire _035_;
 wire _036_;
 wire _037_;
 wire _038_;
 wire _039_;
 wire _040_;
 wire _041_;
 wire _042_;
 wire _043_;
 wire _044_;
 wire _045_;
 wire _046_;
 wire _047_;
 wire _048_;
 wire _049_;
 wire _050_;
 wire _051_;
 wire _052_;
 wire _053_;
 wire _054_;
 wire _055_;
 wire _056_;
 wire _057_;
 wire _058_;
 wire _059_;
 wire _060_;
 wire _061_;
 wire _062_;
 wire _063_;
 wire _064_;
 wire _065_;
 wire _066_;
 wire _067_;
 wire _068_;
 wire _069_;
 wire _070_;
 wire _071_;
 wire _072_;
 wire _073_;
 wire _074_;
 wire _075_;
 wire _076_;
 wire _077_;
 wire _078_;
 wire _079_;
 wire _080_;
 wire _081_;
 wire _082_;
 wire _083_;
 wire _084_;
 wire _085_;
 wire _086_;
 wire _087_;
 wire _088_;
 wire _089_;
 wire _090_;
 wire _091_;
 wire _092_;
 wire _093_;
 wire _094_;
 wire _095_;
 wire _096_;
 wire _097_;
 wire _098_;
 wire _099_;
 wire _100_;
 wire _101_;
 wire _102_;
 wire _103_;
 wire _104_;
 wire _105_;
 wire _106_;
 wire _107_;
 wire _108_;
 wire _109_;
 wire _110_;
 wire _111_;
 wire _112_;
 wire _113_;
 wire _114_;
 wire _115_;
 wire _116_;
 wire _117_;
 wire _118_;
 wire _119_;
 wire _120_;
 wire _121_;
 wire _122_;
 wire _123_;
 wire _124_;
 wire _125_;
 wire _126_;
 wire _127_;

 sg13g2_inv_1 _128_ (.Y(_083_),
    .A(\DPATH.SUM.fa_6.A ));
 sg13g2_inv_1 _129_ (.Y(signB),
    .A(sign));
 sg13g2_inv_1 _130_ (.Y(_084_),
    .A(\DPATH.SUM.fa_3.A ));
 sg13g2_inv_1 _131_ (.Y(_085_),
    .A(\DPATH.SUM.fa_2.A ));
 sg13g2_inv_1 _132_ (.Y(_086_),
    .A(\DPATH.SUM.fa_1.A ));
 sg13g2_inv_1 _133_ (.Y(\DPATH.SUM.ha_0.S ),
    .A(\DPATH.SUM.Cout0 ));
 sg13g2_inv_1 _134_ (.Y(_000_),
    .A(rst));
 sg13g2_nand2_1 _135_ (.Y(_087_),
    .A(\CTRL.S0 ),
    .B(\DPATH.SUM.fa_5.A ));
 sg13g2_xnor2_1 _136_ (.Y(_088_),
    .A(\CTRL.S0 ),
    .B(\DPATH.SUM.fa_5.A ));
 sg13g2_and2_1 _137_ (.A(\CTRL.S0 ),
    .B(\DPATH.SUM.fa_4.A ),
    .X(_089_));
 sg13g2_nand2_1 _138_ (.Y(_090_),
    .A(\CTRL.S0 ),
    .B(\DPATH.SUM.fa_3.A ));
 sg13g2_and2_1 _139_ (.A(\CTRL.S0 ),
    .B(\DPATH.SUM.fa_2.A ),
    .X(_091_));
 sg13g2_nand2_1 _140_ (.Y(_092_),
    .A(\CTRL.S0 ),
    .B(\DPATH.SUM.fa_1.A ));
 sg13g2_xnor2_1 _141_ (.Y(_093_),
    .A(\CTRL.S0 ),
    .B(\DPATH.SUM.fa_1.A ));
 sg13g2_o21ai_1 _142_ (.B1(_092_),
    .Y(_094_),
    .A1(\DPATH.SUM.ha_0.S ),
    .A2(_093_));
 sg13g2_xor2_1 _143_ (.B(\DPATH.SUM.fa_2.A ),
    .A(\CTRL.S0 ),
    .X(_095_));
 sg13g2_a21oi_1 _144_ (.A1(_094_),
    .A2(_095_),
    .Y(_096_),
    .B1(_091_));
 sg13g2_xnor2_1 _145_ (.Y(_097_),
    .A(\CTRL.S0 ),
    .B(\DPATH.SUM.fa_3.A ));
 sg13g2_o21ai_1 _146_ (.B1(_090_),
    .Y(_098_),
    .A1(_096_),
    .A2(_097_));
 sg13g2_xor2_1 _147_ (.B(\DPATH.SUM.fa_4.A ),
    .A(\CTRL.S0 ),
    .X(_099_));
 sg13g2_a21oi_1 _148_ (.A1(_098_),
    .A2(_099_),
    .Y(_100_),
    .B1(_089_));
 sg13g2_xor2_1 _149_ (.B(_100_),
    .A(_088_),
    .X(\DPATH.SUM.fa_5.S ));
 sg13g2_o21ai_1 _150_ (.B1(_087_),
    .Y(_101_),
    .A1(_088_),
    .A2(_100_));
 sg13g2_xnor2_1 _151_ (.Y(_102_),
    .A(\CTRL.S0 ),
    .B(\DPATH.SUM.fa_6.A ));
 sg13g2_xnor2_1 _152_ (.Y(\DPATH.SUM.fa_6.S ),
    .A(_101_),
    .B(_102_));
 sg13g2_or2_1 _153_ (.X(_103_),
    .B(\DPATH.SUM.fa_6.A ),
    .A(\DPATH.SUM.fa_5.A ));
 sg13g2_nor2_1 _154_ (.A(\DPATH.SUM.fa_5.A ),
    .B(\DPATH.SUM.fa_4.A ),
    .Y(_104_));
 sg13g2_nor2_1 _155_ (.A(\DPATH.SUM.fa_3.A ),
    .B(\DPATH.SUM.fa_2.A ),
    .Y(_105_));
 sg13g2_or2_1 _156_ (.X(_106_),
    .B(\DPATH.SUM.fa_2.A ),
    .A(\DPATH.SUM.fa_3.A ));
 sg13g2_nand4_1 _157_ (.B(_086_),
    .C(\DPATH.SUM.Cout0 ),
    .A(\CTRL.S0 ),
    .Y(_107_),
    .D(_105_));
 sg13g2_nor3_1 _158_ (.A(\DPATH.SUM.fa_4.A ),
    .B(_103_),
    .C(_107_),
    .Y(_108_));
 sg13g2_xnor2_1 _159_ (.Y(\CTRL.P1 ),
    .A(signB),
    .B(_108_));
 sg13g2_and2_1 _160_ (.A(\DPATH.SUM.fa_5.A ),
    .B(\DPATH.SUM.fa_4.A ),
    .X(_109_));
 sg13g2_nand2_1 _161_ (.Y(_110_),
    .A(\DPATH.SUM.fa_5.A ),
    .B(\DPATH.SUM.fa_4.A ));
 sg13g2_nor2_1 _162_ (.A(_085_),
    .B(_086_),
    .Y(_111_));
 sg13g2_nand2_1 _163_ (.Y(_112_),
    .A(\DPATH.SUM.fa_2.A ),
    .B(\DPATH.SUM.fa_1.A ));
 sg13g2_nand2_1 _164_ (.Y(_113_),
    .A(\DPATH.SUM.fa_3.A ),
    .B(_111_));
 sg13g2_inv_1 _165_ (.Y(_114_),
    .A(_113_));
 sg13g2_nor3_1 _166_ (.A(\DPATH.SUM.Cout0 ),
    .B(_110_),
    .C(_113_),
    .Y(_115_));
 sg13g2_a21oi_1 _167_ (.A1(\DPATH.SUM.fa_6.A ),
    .A2(_115_),
    .Y(_116_),
    .B1(\CTRL.S0 ));
 sg13g2_nor2_1 _168_ (.A(_108_),
    .B(_116_),
    .Y(\CTRL.P0 ));
 sg13g2_nand2_1 _169_ (.Y(_117_),
    .A(\DPATH.SUM.Cout0 ),
    .B(_111_));
 sg13g2_nor2_1 _170_ (.A(\DPATH.SUM.fa_2.A ),
    .B(\DPATH.SUM.fa_1.A ),
    .Y(_118_));
 sg13g2_xnor2_1 _171_ (.Y(_119_),
    .A(\DPATH.SUM.fa_2.A ),
    .B(\DPATH.SUM.fa_1.A ));
 sg13g2_nor2_1 _172_ (.A(\DPATH.SUM.fa_1.A ),
    .B(\DPATH.SUM.Cout0 ),
    .Y(_120_));
 sg13g2_nor2_1 _173_ (.A(\DPATH.SUM.ha_0.S ),
    .B(_119_),
    .Y(_121_));
 sg13g2_nor2_1 _174_ (.A(_120_),
    .B(_121_),
    .Y(_122_));
 sg13g2_nand2_1 _175_ (.Y(_123_),
    .A(_084_),
    .B(_122_));
 sg13g2_a21oi_1 _176_ (.A1(\DPATH.SUM.fa_3.A ),
    .A2(\DPATH.SUM.fa_1.A ),
    .Y(_124_),
    .B1(\DPATH.SUM.fa_4.A ));
 sg13g2_xnor2_1 _177_ (.Y(_125_),
    .A(\DPATH.SUM.fa_1.A ),
    .B(\DPATH.SUM.Cout0 ));
 sg13g2_xor2_1 _178_ (.B(\DPATH.SUM.Cout0 ),
    .A(\DPATH.SUM.fa_1.A ),
    .X(_126_));
 sg13g2_and2_1 _179_ (.A(\DPATH.SUM.fa_4.A ),
    .B(_113_),
    .X(_127_));
 sg13g2_a221oi_1 _180_ (.B2(_127_),
    .C1(\DPATH.SUM.fa_5.A ),
    .B1(_126_),
    .A1(_123_),
    .Y(_009_),
    .A2(_124_));
 sg13g2_a22oi_1 _181_ (.Y(_010_),
    .B1(_125_),
    .B2(\DPATH.SUM.fa_2.A ),
    .A2(_118_),
    .A1(\DPATH.SUM.Cout0 ));
 sg13g2_and2_1 _182_ (.A(\DPATH.SUM.fa_3.A ),
    .B(_010_),
    .X(_011_));
 sg13g2_nor2b_1 _183_ (.A(\DPATH.SUM.fa_4.A ),
    .B_N(\DPATH.SUM.fa_5.A ),
    .Y(_012_));
 sg13g2_nand2b_1 _184_ (.Y(_013_),
    .B(\DPATH.SUM.fa_5.A ),
    .A_N(\DPATH.SUM.fa_4.A ));
 sg13g2_nor2b_1 _185_ (.A(\DPATH.SUM.fa_2.A ),
    .B_N(\DPATH.SUM.fa_1.A ),
    .Y(_014_));
 sg13g2_nor2_1 _186_ (.A(\DPATH.SUM.fa_3.A ),
    .B(_014_),
    .Y(_015_));
 sg13g2_nand2_1 _187_ (.Y(_016_),
    .A(\DPATH.SUM.fa_2.A ),
    .B(_126_));
 sg13g2_a21oi_1 _188_ (.A1(_015_),
    .A2(_016_),
    .Y(_017_),
    .B1(_011_));
 sg13g2_nand2_1 _189_ (.Y(_018_),
    .A(_012_),
    .B(_017_));
 sg13g2_nand2_1 _190_ (.Y(_019_),
    .A(\DPATH.SUM.fa_2.A ),
    .B(\DPATH.SUM.Cout0 ));
 sg13g2_o21ai_1 _191_ (.B1(_019_),
    .Y(_020_),
    .A1(\DPATH.SUM.Cout0 ),
    .A2(_119_));
 sg13g2_a21oi_1 _192_ (.A1(\DPATH.SUM.Cout0 ),
    .A2(_118_),
    .Y(_021_),
    .B1(_020_));
 sg13g2_o21ai_1 _193_ (.B1(\DPATH.SUM.fa_2.A ),
    .Y(_022_),
    .A1(\DPATH.SUM.fa_1.A ),
    .A2(\DPATH.SUM.Cout0 ));
 sg13g2_nor2_1 _194_ (.A(_084_),
    .B(_022_),
    .Y(_023_));
 sg13g2_nor3_1 _195_ (.A(_110_),
    .B(_021_),
    .C(_023_),
    .Y(_024_));
 sg13g2_nor4_1 _196_ (.A(\DPATH.SUM.fa_6.A ),
    .B(_115_),
    .C(_009_),
    .D(_024_),
    .Y(_025_));
 sg13g2_xor2_1 _197_ (.B(\DPATH.SUM.Cout0 ),
    .A(\DPATH.SUM.fa_2.A ),
    .X(_026_));
 sg13g2_nor2_1 _198_ (.A(\DPATH.SUM.fa_3.A ),
    .B(_026_),
    .Y(_027_));
 sg13g2_o21ai_1 _199_ (.B1(\DPATH.SUM.fa_4.A ),
    .Y(_028_),
    .A1(_011_),
    .A2(_027_));
 sg13g2_xnor2_1 _200_ (.Y(_029_),
    .A(_015_),
    .B(_026_));
 sg13g2_o21ai_1 _201_ (.B1(\DPATH.SUM.fa_6.A ),
    .Y(_030_),
    .A1(\DPATH.SUM.fa_4.A ),
    .A2(_029_));
 sg13g2_nand2b_1 _202_ (.Y(_031_),
    .B(_028_),
    .A_N(_030_));
 sg13g2_nand2b_1 _203_ (.Y(_032_),
    .B(_022_),
    .A_N(_118_));
 sg13g2_nand3b_1 _204_ (.B(\DPATH.SUM.fa_3.A ),
    .C(_032_),
    .Y(_033_),
    .A_N(\DPATH.SUM.fa_4.A ));
 sg13g2_nand2_1 _205_ (.Y(_034_),
    .A(\DPATH.SUM.ha_0.S ),
    .B(_118_));
 sg13g2_and3_1 _206_ (.X(_035_),
    .A(\DPATH.SUM.fa_4.A ),
    .B(\DPATH.SUM.fa_1.A ),
    .C(\DPATH.SUM.Cout0 ));
 sg13g2_a21oi_1 _207_ (.A1(\DPATH.SUM.fa_4.A ),
    .A2(_106_),
    .Y(_036_),
    .B1(_035_));
 sg13g2_a21oi_1 _208_ (.A1(\DPATH.SUM.fa_3.A ),
    .A2(_034_),
    .Y(_037_),
    .B1(_036_));
 sg13g2_and2_1 _209_ (.A(\DPATH.SUM.fa_5.A ),
    .B(\DPATH.SUM.fa_6.A ),
    .X(_038_));
 sg13g2_nor2_1 _210_ (.A(\DPATH.SUM.fa_4.A ),
    .B(\DPATH.SUM.fa_3.A ),
    .Y(_039_));
 sg13g2_a21oi_1 _211_ (.A1(_086_),
    .A2(_039_),
    .Y(_040_),
    .B1(_037_));
 sg13g2_nand3_1 _212_ (.B(_038_),
    .C(_040_),
    .A(_033_),
    .Y(_041_));
 sg13g2_o21ai_1 _213_ (.B1(_041_),
    .Y(_042_),
    .A1(\DPATH.SUM.fa_5.A ),
    .A2(_031_));
 sg13g2_a21oi_1 _214_ (.A1(_018_),
    .A2(_025_),
    .Y(sine_out[0]),
    .B1(_042_));
 sg13g2_a22oi_1 _215_ (.Y(_043_),
    .B1(_027_),
    .B2(_112_),
    .A2(_021_),
    .A1(\DPATH.SUM.fa_3.A ));
 sg13g2_nand2_1 _216_ (.Y(_044_),
    .A(\DPATH.SUM.fa_3.A ),
    .B(_019_));
 sg13g2_xor2_1 _217_ (.B(_044_),
    .A(_010_),
    .X(_045_));
 sg13g2_nor2b_1 _218_ (.A(\DPATH.SUM.fa_5.A ),
    .B_N(\DPATH.SUM.fa_4.A ),
    .Y(_046_));
 sg13g2_nand3_1 _219_ (.B(\DPATH.SUM.fa_1.A ),
    .C(\DPATH.SUM.Cout0 ),
    .A(_084_),
    .Y(_047_));
 sg13g2_nand2_1 _220_ (.Y(_048_),
    .A(_026_),
    .B(_047_));
 sg13g2_a221oi_1 _221_ (.B2(_104_),
    .C1(\DPATH.SUM.fa_6.A ),
    .B1(_048_),
    .A1(_020_),
    .Y(_049_),
    .A2(_046_));
 sg13g2_o21ai_1 _222_ (.B1(_049_),
    .Y(_050_),
    .A1(_013_),
    .A2(_043_));
 sg13g2_a21oi_1 _223_ (.A1(_109_),
    .A2(_045_),
    .Y(_051_),
    .B1(_050_));
 sg13g2_nor2_1 _224_ (.A(\DPATH.SUM.fa_3.A ),
    .B(_118_),
    .Y(_052_));
 sg13g2_a22oi_1 _225_ (.Y(_053_),
    .B1(_126_),
    .B2(_052_),
    .A2(_122_),
    .A1(\DPATH.SUM.fa_3.A ));
 sg13g2_nor2b_1 _226_ (.A(_053_),
    .B_N(_104_),
    .Y(_054_));
 sg13g2_a22oi_1 _227_ (.Y(_055_),
    .B1(_052_),
    .B2(_016_),
    .A2(_032_),
    .A1(\DPATH.SUM.fa_3.A ));
 sg13g2_nand2b_1 _228_ (.Y(_056_),
    .B(_046_),
    .A_N(_055_));
 sg13g2_a21oi_1 _229_ (.A1(_084_),
    .A2(\DPATH.SUM.fa_2.A ),
    .Y(_057_),
    .B1(\DPATH.SUM.fa_4.A ));
 sg13g2_nand2_1 _230_ (.Y(_058_),
    .A(\DPATH.SUM.fa_5.A ),
    .B(_036_));
 sg13g2_a21oi_1 _231_ (.A1(_022_),
    .A2(_057_),
    .Y(_059_),
    .B1(_058_));
 sg13g2_nor3_1 _232_ (.A(_083_),
    .B(_054_),
    .C(_059_),
    .Y(_060_));
 sg13g2_a21oi_1 _233_ (.A1(_056_),
    .A2(_060_),
    .Y(sine_out[1]),
    .B1(_051_));
 sg13g2_nor3_1 _234_ (.A(\DPATH.SUM.fa_4.A ),
    .B(_085_),
    .C(_126_),
    .Y(_061_));
 sg13g2_nor3_1 _235_ (.A(_014_),
    .B(_035_),
    .C(_061_),
    .Y(_062_));
 sg13g2_xnor2_1 _236_ (.Y(_063_),
    .A(\DPATH.SUM.fa_3.A ),
    .B(_062_));
 sg13g2_nand2b_1 _237_ (.Y(_064_),
    .B(_032_),
    .A_N(\DPATH.SUM.fa_3.A ));
 sg13g2_nor2b_1 _238_ (.A(_118_),
    .B_N(\DPATH.SUM.fa_3.A ),
    .Y(_065_));
 sg13g2_o21ai_1 _239_ (.B1(_065_),
    .Y(_066_),
    .A1(\DPATH.SUM.fa_2.A ),
    .A2(\DPATH.SUM.Cout0 ));
 sg13g2_o21ai_1 _240_ (.B1(_064_),
    .Y(_067_),
    .A1(_111_),
    .A2(_066_));
 sg13g2_o21ai_1 _241_ (.B1(_047_),
    .Y(_068_),
    .A1(_106_),
    .A2(_120_));
 sg13g2_a21o_1 _242_ (.A2(_119_),
    .A1(\DPATH.SUM.fa_3.A ),
    .B1(_068_),
    .X(_069_));
 sg13g2_a22oi_1 _243_ (.Y(_070_),
    .B1(_069_),
    .B2(_109_),
    .A2(_067_),
    .A1(_012_));
 sg13g2_nand3_1 _244_ (.B(_034_),
    .C(_064_),
    .A(_112_),
    .Y(_071_));
 sg13g2_nor3_1 _245_ (.A(_105_),
    .B(_013_),
    .C(_023_),
    .Y(_072_));
 sg13g2_o21ai_1 _246_ (.B1(_022_),
    .Y(_073_),
    .A1(\DPATH.SUM.fa_3.A ),
    .A2(_118_));
 sg13g2_o21ai_1 _247_ (.B1(_073_),
    .Y(_074_),
    .A1(_085_),
    .A2(_047_));
 sg13g2_a221oi_1 _248_ (.B2(_046_),
    .C1(_072_),
    .B1(_074_),
    .A1(_104_),
    .Y(_075_),
    .A2(_071_));
 sg13g2_mux2_1 _249_ (.A0(_070_),
    .A1(_075_),
    .S(\DPATH.SUM.fa_6.A ),
    .X(_076_));
 sg13g2_o21ai_1 _250_ (.B1(_076_),
    .Y(sine_out[2]),
    .A1(_103_),
    .A2(_063_));
 sg13g2_nand2_1 _251_ (.Y(_077_),
    .A(_022_),
    .B(_039_));
 sg13g2_nor2_1 _252_ (.A(_103_),
    .B(_077_),
    .Y(sine_out[3]));
 sg13g2_nor3_1 _253_ (.A(\DPATH.SUM.fa_4.A ),
    .B(_103_),
    .C(_065_),
    .Y(sine_out[4]));
 sg13g2_and3_1 _254_ (.X(_078_),
    .A(\DPATH.SUM.fa_3.A ),
    .B(\DPATH.SUM.Cout0 ),
    .C(_111_));
 sg13g2_nor3_1 _255_ (.A(\DPATH.SUM.fa_4.A ),
    .B(_103_),
    .C(_078_),
    .Y(sine_out[5]));
 sg13g2_a21oi_1 _256_ (.A1(\DPATH.SUM.fa_4.A ),
    .A2(_106_),
    .Y(sine_out[6]),
    .B1(_103_));
 sg13g2_a21oi_1 _257_ (.A1(\DPATH.SUM.fa_4.A ),
    .A2(_065_),
    .Y(sine_out[7]),
    .B1(_103_));
 sg13g2_a21oi_1 _258_ (.A1(\DPATH.SUM.fa_4.A ),
    .A2(_078_),
    .Y(sine_out[8]),
    .B1(_103_));
 sg13g2_a21oi_1 _259_ (.A1(\DPATH.SUM.fa_5.A ),
    .A2(_077_),
    .Y(sine_out[9]),
    .B1(\DPATH.SUM.fa_6.A ));
 sg13g2_nand3b_1 _260_ (.B(_083_),
    .C(_066_),
    .Y(_079_),
    .A_N(\DPATH.SUM.fa_4.A ));
 sg13g2_nand2_1 _261_ (.Y(sine_out[10]),
    .A(_103_),
    .B(_079_));
 sg13g2_a21oi_1 _262_ (.A1(_105_),
    .A2(_120_),
    .Y(_080_),
    .B1(_110_));
 sg13g2_nor2_1 _263_ (.A(\DPATH.SUM.fa_6.A ),
    .B(_080_),
    .Y(sine_out[11]));
 sg13g2_nand2b_1 _264_ (.Y(_081_),
    .B(_117_),
    .A_N(\DPATH.SUM.fa_3.A ));
 sg13g2_a21oi_1 _265_ (.A1(_109_),
    .A2(_081_),
    .Y(sine_out[12]),
    .B1(\DPATH.SUM.fa_6.A ));
 sg13g2_a21oi_1 _266_ (.A1(_109_),
    .A2(_114_),
    .Y(sine_out[13]),
    .B1(\DPATH.SUM.fa_6.A ));
 sg13g2_o21ai_1 _267_ (.B1(\DPATH.SUM.fa_6.A ),
    .Y(sine_out[14]),
    .A1(\DPATH.SUM.fa_5.A ),
    .A2(_077_));
 sg13g2_a21o_1 _268_ (.A2(_113_),
    .A1(_104_),
    .B1(_083_),
    .X(sine_out[15]));
 sg13g2_and2_1 _269_ (.A(\DPATH.SUM.fa_4.A ),
    .B(\DPATH.SUM.fa_6.A ),
    .X(_082_));
 sg13g2_a21oi_1 _270_ (.A1(_081_),
    .A2(_082_),
    .Y(sine_out[16]),
    .B1(_038_));
 sg13g2_o21ai_1 _271_ (.B1(_038_),
    .Y(sine_out[17]),
    .A1(\DPATH.SUM.fa_4.A ),
    .A2(_106_));
 sg13g2_xnor2_1 _272_ (.Y(\DPATH.SUM.fa_1.S ),
    .A(\DPATH.SUM.Cout0 ),
    .B(_093_));
 sg13g2_xor2_1 _273_ (.B(_095_),
    .A(_094_),
    .X(\DPATH.SUM.fa_2.S ));
 sg13g2_xor2_1 _274_ (.B(_097_),
    .A(_096_),
    .X(\DPATH.SUM.fa_3.S ));
 sg13g2_xor2_1 _275_ (.B(_099_),
    .A(_098_),
    .X(\DPATH.SUM.fa_4.S ));
 sg13g2_inv_1 _276_ (.Y(_001_),
    .A(rst));
 sg13g2_inv_1 _277_ (.Y(_002_),
    .A(rst));
 sg13g2_inv_1 _278_ (.Y(_003_),
    .A(rst));
 sg13g2_inv_1 _279_ (.Y(_004_),
    .A(rst));
 sg13g2_inv_1 _280_ (.Y(_005_),
    .A(rst));
 sg13g2_inv_1 _281_ (.Y(_006_),
    .A(rst));
 sg13g2_inv_1 _282_ (.Y(_007_),
    .A(rst));
 sg13g2_inv_1 _283_ (.Y(_008_),
    .A(rst));
 sg13g2_dfrbpq_1 _284_ (.RESET_B(_000_),
    .D(\DPATH.SUM.ha_0.S ),
    .Q(\DPATH.SUM.Cout0 ),
    .CLK(clk));
 sg13g2_dfrbpq_1 _285_ (.RESET_B(_001_),
    .D(\DPATH.SUM.fa_1.S ),
    .Q(\DPATH.SUM.fa_1.A ),
    .CLK(clk));
 sg13g2_dfrbpq_1 _286_ (.RESET_B(_002_),
    .D(\DPATH.SUM.fa_2.S ),
    .Q(\DPATH.SUM.fa_2.A ),
    .CLK(clk));
 sg13g2_dfrbpq_1 _287_ (.RESET_B(_003_),
    .D(\DPATH.SUM.fa_3.S ),
    .Q(\DPATH.SUM.fa_3.A ),
    .CLK(clk));
 sg13g2_dfrbpq_1 _288_ (.RESET_B(_004_),
    .D(\DPATH.SUM.fa_4.S ),
    .Q(\DPATH.SUM.fa_4.A ),
    .CLK(clk));
 sg13g2_dfrbpq_1 _289_ (.RESET_B(_005_),
    .D(\DPATH.SUM.fa_5.S ),
    .Q(\DPATH.SUM.fa_5.A ),
    .CLK(clk));
 sg13g2_dfrbpq_1 _290_ (.RESET_B(_006_),
    .D(\DPATH.SUM.fa_6.S ),
    .Q(\DPATH.SUM.fa_6.A ),
    .CLK(clk));
 sg13g2_dfrbpq_1 _291_ (.RESET_B(_007_),
    .D(\CTRL.P1 ),
    .Q(sign),
    .CLK(clk));
 sg13g2_dfrbpq_1 _292_ (.RESET_B(_008_),
    .D(\CTRL.P0 ),
    .Q(\CTRL.S0 ),
    .CLK(clk));
endmodule
