nbertamoni/BASIC/current_generator/digital/DigitalSine/runs/RUN_2026-02-26_20-53-18/28-openroad-globalplacement/DigitalSine.pnl.v

module DigitalSine (clk,
    rst,
    sign,
    signB,
    VGND,
    VPWR,
    sine_out);
 input clk;
 input rst;
 output sign;
 output signB;
 inout VGND;
 inout VPWR;
 output [17:0] sine_out;

 wire \CTRL.P0 ;
 wire \CTRL.P1 ;
 wire \CTRL.S0 ;
 wire \DPATH.SUM.Cout0 ;
 wire \DPATH.SUM.fa_1.A ;
 wire \DPATH.SUM.fa_1.S ;
 wire \DPATH.SUM.fa_2.A ;
 wire \DPATH.SUM.fa_2.S ;
 wire \DPATH.SUM.fa_3.A ;
 wire \DPATH.SUM.fa_3.S ;
 wire \DPATH.SUM.fa_4.A ;
 wire \DPATH.SUM.fa_4.S ;
 wire \DPATH.SUM.fa_5.A ;
 wire \DPATH.SUM.fa_5.S ;
 wire \DPATH.SUM.fa_6.A ;
 wire \DPATH.SUM.fa_6.S ;
 wire \DPATH.SUM.ha_0.S ;
 wire _000_;
 wire _001_;
 wire _002_;
 wire _003_;
 wire _004_;
 wire _005_;
 wire _006_;
 wire _007_;
 wire _008_;
 wire _009_;
 wire _010_;
 wire _011_;
 wire _012_;
 wire _013_;
 wire _014_;
 wire _015_;
 wire _016_;
 wire _017_;
 wire _018_;
 wire _019_;
 wire _020_;
 wire _021_;
 wire _022_;
 wire _023_;
 wire _024_;
 wire _025_;
 wire _026_;
 wire _027_;
 wire _028_;
 wire _029_;
 wire _030_;
 wire _031_;
 wire _032_;
 wire _033_;
 wire _034_;
 wire _035_;
 wire _036_;
 wire _037_;
 wire _038_;
 wire _039_;
 wire _040_;
 wire _041_;
 wire _042_;
 wire _043_;
 wire _044_;
 wire _045_;
 wire _046_;
 wire _047_;
 wire _048_;
 wire _049_;
 wire _050_;
 wire _051_;
 wire _052_;
 wire _053_;
 wire _054_;
 wire _055_;
 wire _056_;
 wire _057_;
 wire _058_;
 wire _059_;
 wire _060_;
 wire _061_;
 wire _062_;
 wire _063_;
 wire _064_;
 wire _065_;
 wire _066_;
 wire _067_;
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
 sg13g2_buf_4 fanout65 (.X(net65),
    .A(\DPATH.SUM.fa_1.A ),
    .VDD(VPWR),
    .VSS(VGND));
 sg13g2_buf_4 fanout66 (.X(net66),
    .A(\DPATH.SUM.Cout0 ),
    .VDD(VPWR),
    .VSS(VGND));
 sg13g2_buf_4 fanout67 (.X(net67),
    .A(\DPATH.SUM.Cout0 ),
    .VDD(VPWR),
    .VSS(VGND));
endmodule
