nbertamoni/BASIC/current_generator/digital/DigitalSine/files_rtl/sineDecoder.v

// Created by ihdl
module sineDecoder (
	input	[6:0] A,
	output reg 	[17:0] Y
);

	always @ (A) begin
		case (A)
  //                      7'b0000000: Y = 18'b000000000000000000;
            7'b0000000: Y = 18'b000000000000000001;
            7'b0000001: Y = 18'b000000000000000010;
            7'b0000010: Y = 18'b000000000000000100;
            7'b0000011: Y = 18'b000000000000000101;
            7'b0000100: Y = 18'b000000000000000111;
            7'b0000101: Y = 18'b000000000000001001;
            7'b0000110: Y = 18'b000000000000001010;
            7'b0000111: Y = 18'b000000000000001100;
            7'b0001000: Y = 18'b000000000000001101;
            7'b0001001: Y = 18'b000000000000001111;
            7'b0001010: Y = 18'b000000000000011000;
            7'b0001011: Y = 18'b000000000000011010;
            7'b0001100: Y = 18'b000000000000011011;
            7'b0001101: Y = 18'b000000000000011101;
            7'b0001110: Y = 18'b000000000000011110;
            7'b0001111: Y = 18'b000000000000111000;
            7'b0010000: Y = 18'b000000000000111010;
            7'b0010001: Y = 18'b000000000000111011;
            7'b0010010: Y = 18'b000000000000111101;
            7'b0010011: Y = 18'b000000000000111110;
            7'b0010100: Y = 18'b000000000001111000;
            7'b0010101: Y = 18'b000000000001111001;
            7'b0010110: Y = 18'b000000000001111011;
            7'b0010111: Y = 18'b000000000001111100;
            7'b0011000: Y = 18'b000000000001111110;
            7'b0011001: Y = 18'b000000000001111111;
            7'b0011010: Y = 18'b000000000011111001;
            7'b0011011: Y = 18'b000000000011111010;
            7'b0011100: Y = 18'b000000000011111100;
            7'b0011101: Y = 18'b000000000011111101;
            7'b0011110: Y = 18'b000000000011111110;
            7'b0011111: Y = 18'b000000000111111000;
            7'b0100000: Y = 18'b000000000111111001;
            7'b0100001: Y = 18'b000000000111111011;
            7'b0100010: Y = 18'b000000000111111100;
            7'b0100011: Y = 18'b000000000111111110;
            7'b0100100: Y = 18'b000000000111111111;
            7'b0100101: Y = 18'b000000001111111000;
            7'b0100110: Y = 18'b000000001111111010;
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
//			default: Y = 18'b000000000000000000000000000000000;
		endcase
	end
endmodule
