nbertamoni/BASIC/(commit log)

2025-12-09 first commit as a test
    [inverter_test.sch]
2025-12-09 folder structure sugestion
    [nand_nand_CS.sch]
2025-12-13 Files for digital flow DigitalSine
    [pin_order.cfg]
2025-12-13 Removing runs
    [DigitalSine__nom_fast_1p32V_m40C.sdf, DigitalSine__nom_slow_1p08V_125C.sdf, DigitalSine__nom_typ_1p20V_25C.sdf, metrics.csv, net-VGND.csv, net-VPWR.csv, wire_lengths.csv]
2025-12-14 new runs
    [DigitalSine__nom_fast_1p32V_m40C.sdf, DigitalSine__nom_slow_1p08V_125C.sdf, DigitalSine__nom_typ_1p20V_25C.sdf, metrics.csv, metrics_compare.csv, metrics_directions.csv, net-VGND.csv, net-VPWR.csv]
2025-12-15 new run with 55 utilization and lees delay into IO ports
    [DigitalSine__nom_fast_1p32V_m40C.sdf, DigitalSine__nom_slow_1p08V_125C.sdf, DigitalSine__nom_typ_1p20V_25C.sdf, metrics.csv, metrics_compare.csv, net-VGND.csv, net-VPWR.csv, wire_lengths.csv]
2025-12-15 New runs, deleted old runs. Better results with 58 utilization
    [DigitalSine__nom_fast_1p32V_m40C.sdf, DigitalSine__nom_slow_1p08V_125C.sdf, DigitalSine__nom_typ_1p20V_25C.sdf, metrics.csv, metrics_compare.csv, net-VGND.csv, net-VPWR.csv, wire_lengths.csv]
2026-01-28 mock tapeout- only a resistor was added and connected to pins. DRC clena except for density
2026-02-05 more digital designs
    [DigitalSine__nom_fast_1p32V_m40C.sdf, DigitalSine__nom_slow_1p08V_125C.sdf, DigitalSine__nom_typ_1p20V_25C.sdf, inverter_test.sch, metrics.csv, metrics_compare.csv, metrics_directions.csv, nand_nand_CS.sch]
2026-02-10 Updating FDDA files from cesar
    [FDDA.sch, FDDA_TB.sch]
2026-02-27 DAC commited
    [IGEN_DAC.sch, adc_segmentation.sch, buffer.sch, byn_dac.sch, current_mirror.sch, current_mirror_nmos.sch, dac.sch, dac_bin_1.sch]
2026-02-28 Solved symbol reference problems modifying the file -xschemrc- and placed the files in correct place.
    [IGEN_DAC.sch, adc_segmentation.sch, buffer.sch, byn_dac.sch, current_mirror.sch, current_mirror_nmos.sch, dac.sch, dac_bin_1.sch]
2026-02-28 DigitalSin form 33 bit to 18 bits
    [DigitalSine__nom_fast_1p32V_m40C.sdf, DigitalSine__nom_slow_1p08V_125C.sdf, DigitalSine__nom_typ_1p20V_25C.sdf, metrics.csv, metrics_compare.csv, metrics_directions.csv, net-VGND.csv, net-VPWR.csv]
2026-02-28 dac_top and dac_top_extcap created and tested
    [dac.sch, dac_thermo_top_2.sch, dac_top.sch, dac_top_extcap.sch, test.sch]
2026-03-02 Clean up digital results
    [DigitalSine__nom_fast_1p32V_m40C.sdf, DigitalSine__nom_slow_1p08V_125C.sdf, DigitalSine__nom_typ_1p20V_25C.sdf, metrics.csv, metrics_compare.csv, metrics_directions.csv, net-VGND.csv, net-VPWR.csv]
2026-03-02 reorganization of schematics and layout
    [IGEN_DAC.sch, adc_segmentation.sch, buffer.sch, byn_dac.sch, current_mirror.sch, current_mirror_nmos.sch, dac.sch, dac_bin_1.sch]
2026-03-03 The W/L of the device of the enable and dummy was changed
    [dac.sch]
2026-03-03 inversor pra substitruir stdcell que gera problema
    [inverter.sch]
2026-03-03 nand pra substitruir stdcell que gera problema qd gera netlist
    [nand.sch]
2026-03-03 substituição dos inversores e NAND stdcell por handmade
    [current_mirror.sch, dac.sch, dac_thermo.sch]
2026-03-03 std substituidas pelas cells do nbertamoni
    [non_overlap.sch]
2026-03-03 versao do dac para dryrun 0603
    [lvs_dac_test_2.sch]
2026-03-03 modifications do go-nogo
    [IGEN_DAC_reduced.sch, dac.sch, dac_gold.sch, lvs_dac_test_2.sch]
2026-03-04 dac_top_reduced created. In the non overlap block, the pin changed from in to i_sign and i_signb added. pins a and b were removed too. sch of the dac_top and dac_top_extcap were updated.
    [dac_top.sch, dac_top_extcap.sch, dac_top_reduced.sch, non_overlap.sch, untitled-3.sch]
2026-03-04 non_overlap's pin modified from in and inb to i_sign and i_signb.
    [non_overlap.sch]
2026-03-04 non_overlap's pins a and b added again. Capacitor connected in the VBIAS removed and it was added VBIAS pin to connect this cap on the top in the future.
    [dac_top_reduced.sch, non_overlap.sch]
2026-03-04 pin a and b added in the symbol
    [dac_top_reduced.sch]
2026-03-04 Init. debug layout capacitor MIM
    [capacitor_MIM.sch]
2026-03-05 Correçao de alinhamento de texto
2026-03-05 Melhora na estrutura do texto para melhor compreensão
2026-03-08 Gold schematics of the DAC added
    [dac_top.sch, dsw_gold.sch, non_overlap_gold.sch, sub_top_gold.sch, tb_dac_top.sch, test.sch, tgate_gold.sch]
2026-09-10 dac_gold DRC and LVS clean after PDK updates
    [dac_gold.sch]
2026-09-16 Updated analog layouts
    [current_mirror.sch, dac_DUMMIE.sch, dac_bits.sch, dac_gold.sch, dac_top_gold.sch, dac_top_no_cm.sch, dac_top_reduced_06_03_2026.sch, non_overlap_gold.sch]
